ItsGoodButStill/IGBS-Rocket-v2/img/2021/DSC05149.jpg

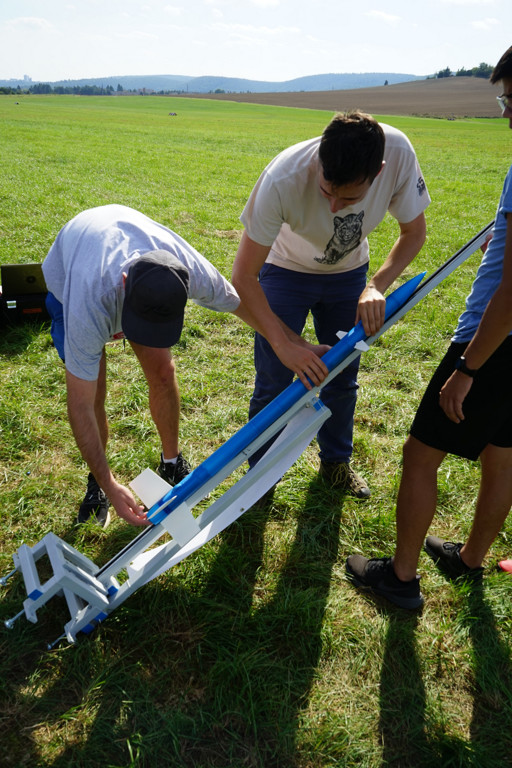
img/2021/DSC05149.jpg
