ItsGoodButStill/IGBS-Rocket-v2/img/team/parezjan.JPEG

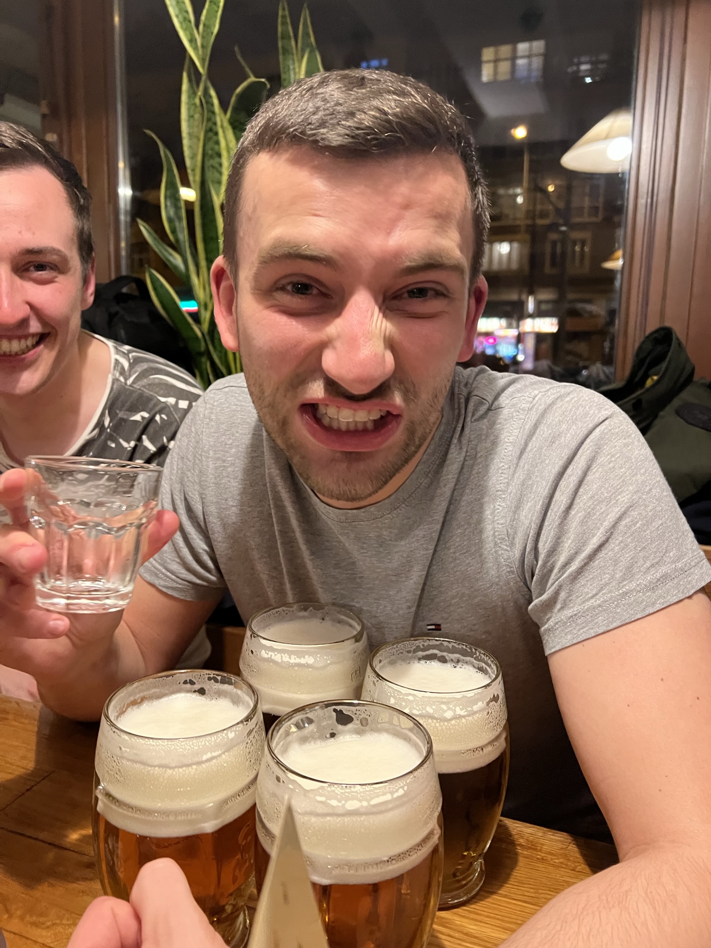
img/team/parezjan.JPEG
