ItsGoodButStill/IGBS-Rocket-v2/README.md

# Its Good But Still V2 (2022)

<p float="left" align="center">
  IGBS 2021
</p>
