ItsGoodButStill/IGBS-Rocket-v2/doc/cubemx.png

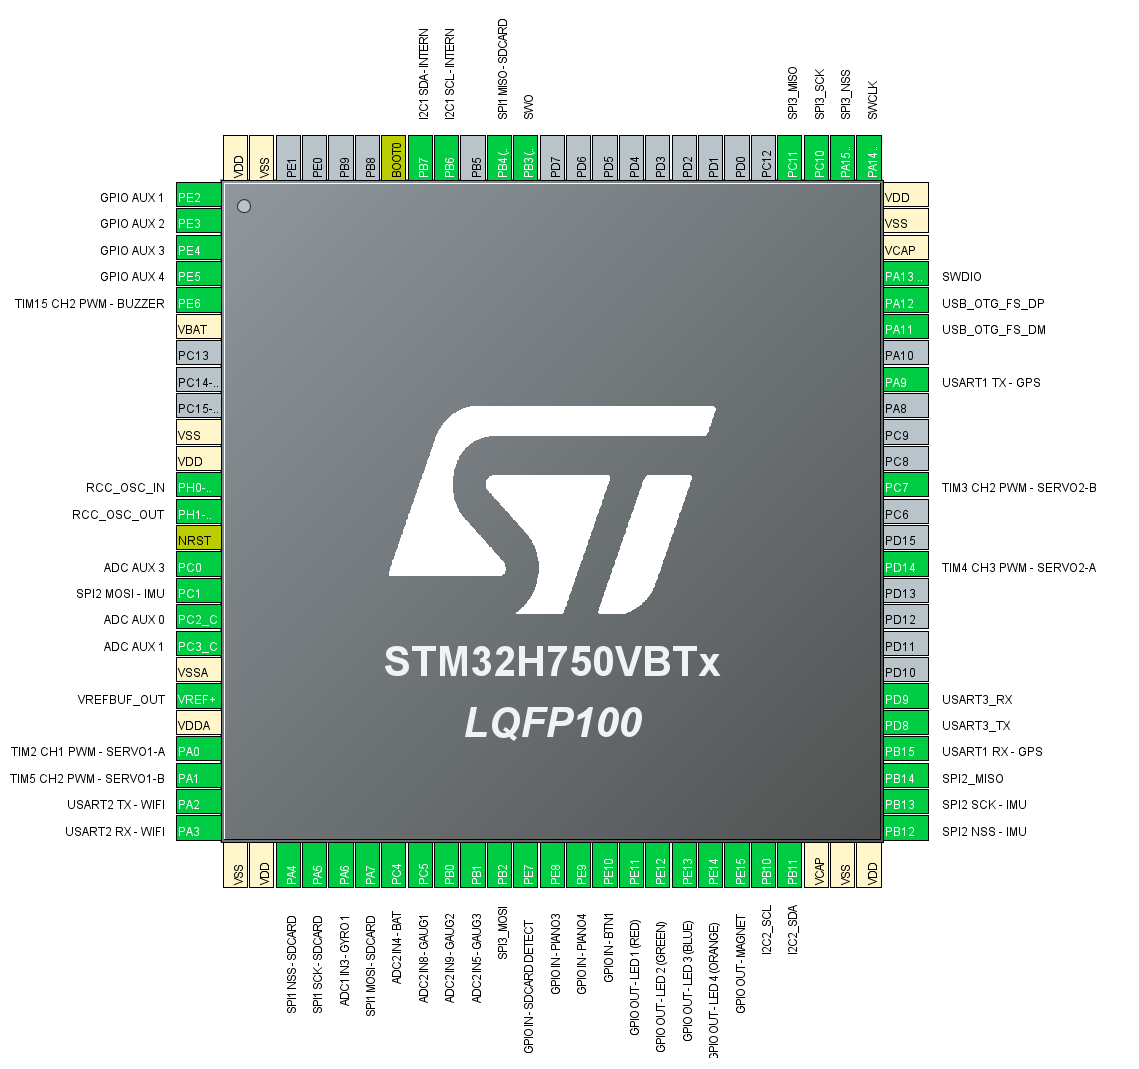
doc/cubemx.png
