ItsGoodButStill/IGBS-Rocket-v2/img/2021/DSC05082.jpg

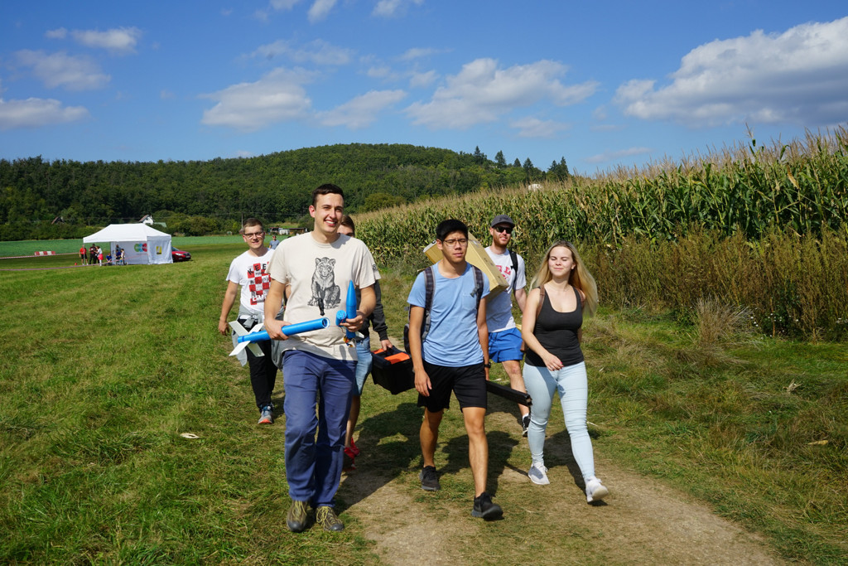
img/2021/DSC05082.jpg
