ItsGoodButStill/IGBS-Rocket-v2/img/2021/DSC05179.jpg

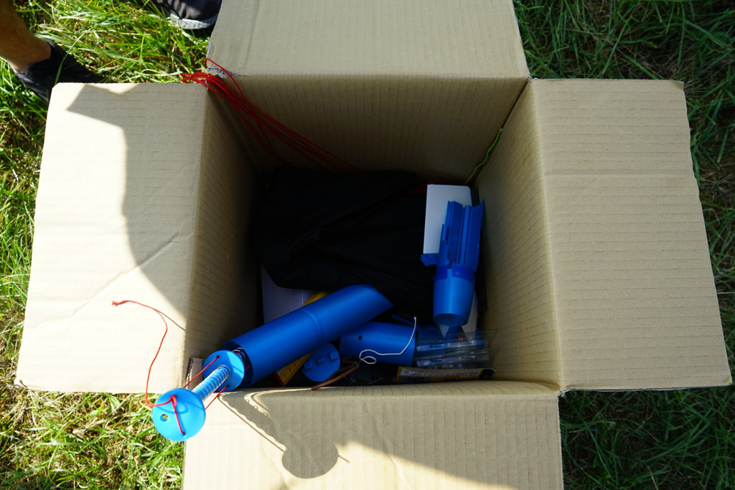
img/2021/DSC05179.jpg
