ItsGoodButStill/IGBS-Rocket-v2/img/IGBS.bmp

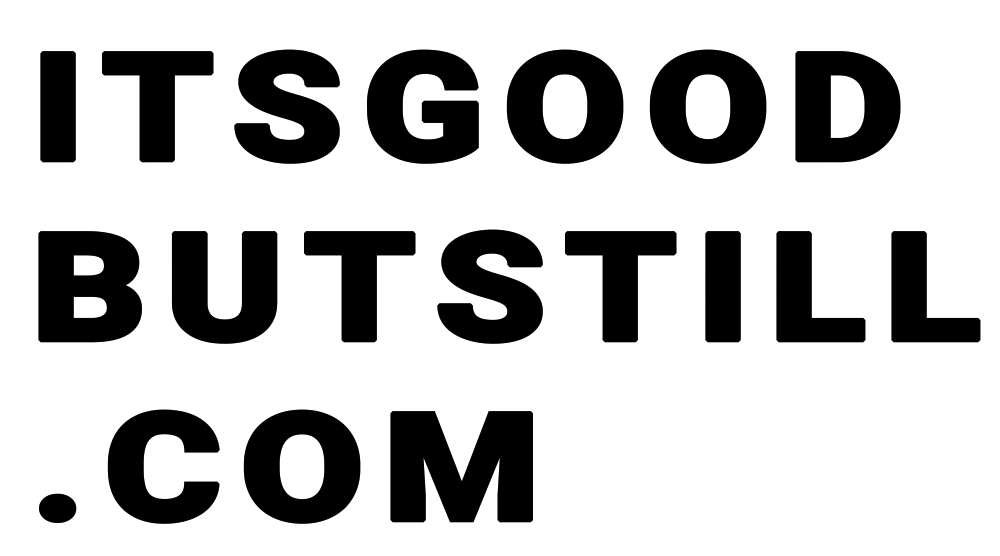
img/IGBS.bmp
