ItsGoodButStill/IGBS-Rocket-v2/img/stumpy.png

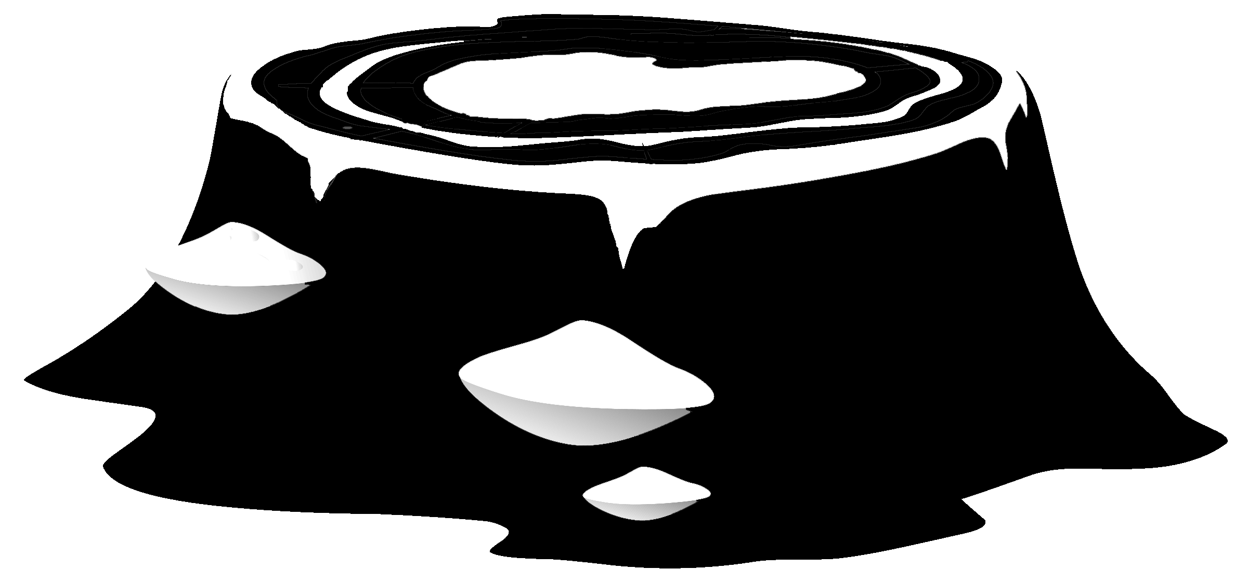
img/stumpy.png
