ItsGoodButStill/IGBS-Rocket-v2/img/symbol_cvut_plna_samostatna_verze_cb.bmp

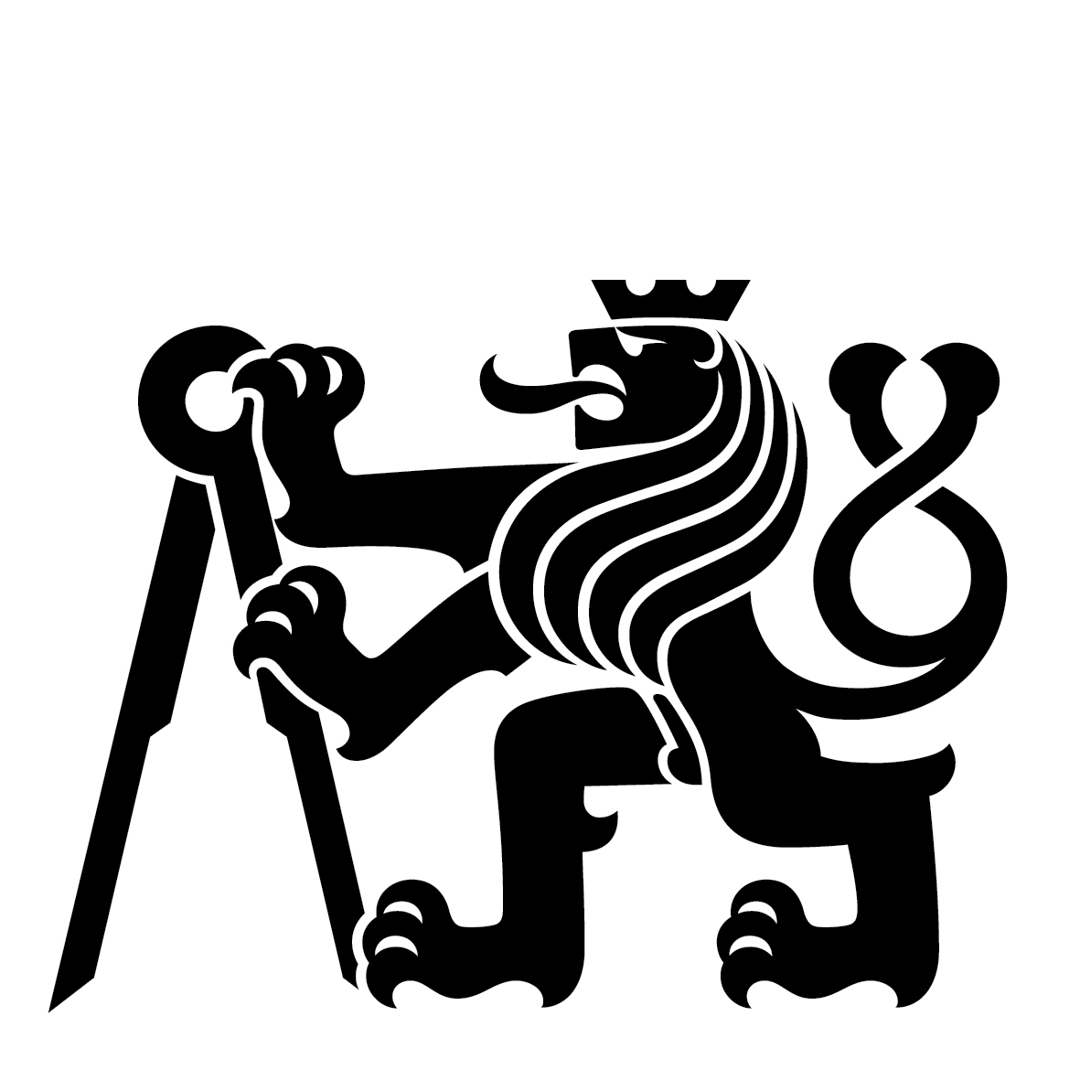
img/symbol_cvut_plna_samostatna_verze_cb.bmp
