ItsGoodButStill/IGBS-Rocket-v2/img/team/IMG_2238.JPEG

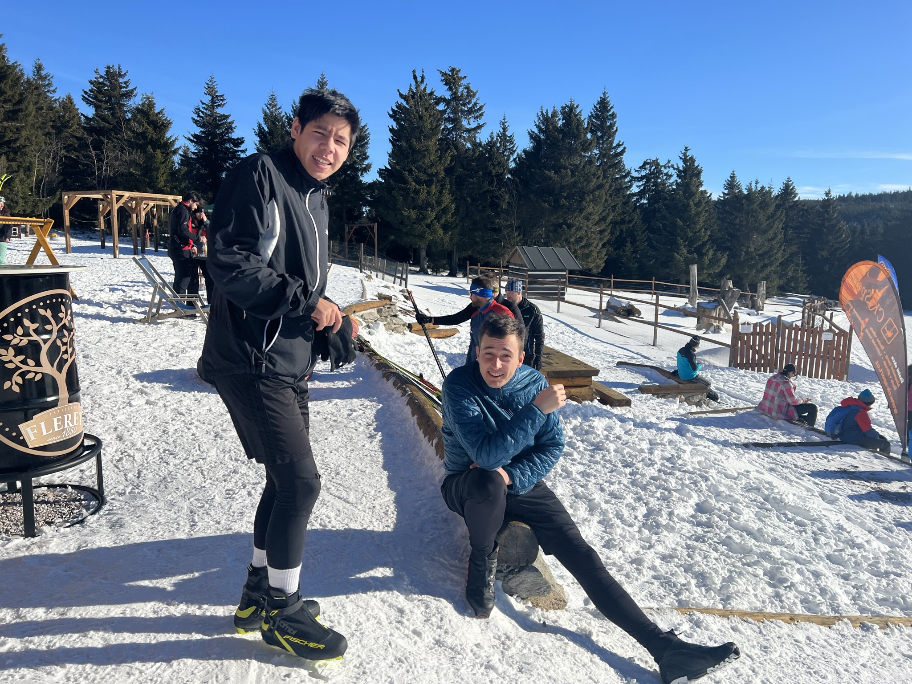
img/team/IMG_2238.JPEG
