ItsGoodButStill/IGBS-Rocket-v2/img/team/IMG_6708.JPEG

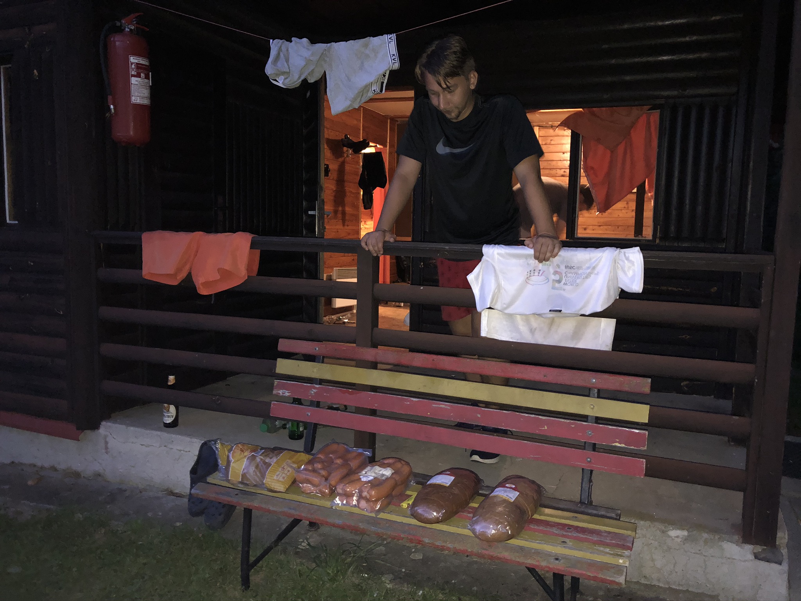
img/team/IMG_6708.JPEG
