ItsGoodButStill/IGBS-Rocket-v2/img/team/kankato2.JPEG

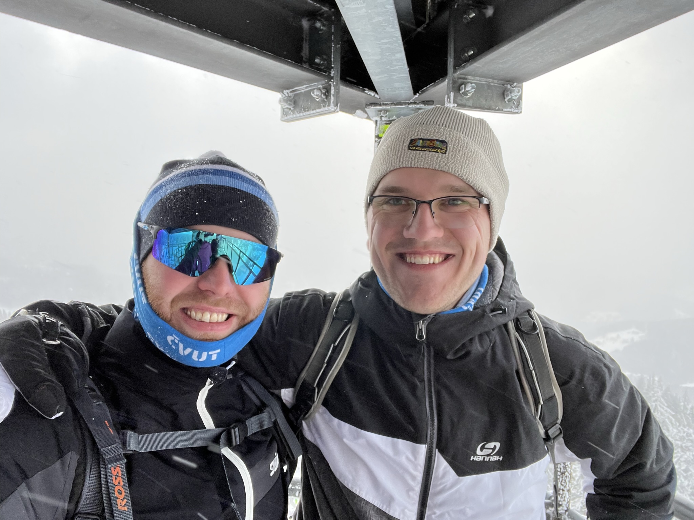
img/team/kankato2.JPEG
