ItsGoodButStill/IGBS-Rocket-v2/img/team/kankato2b.jpg

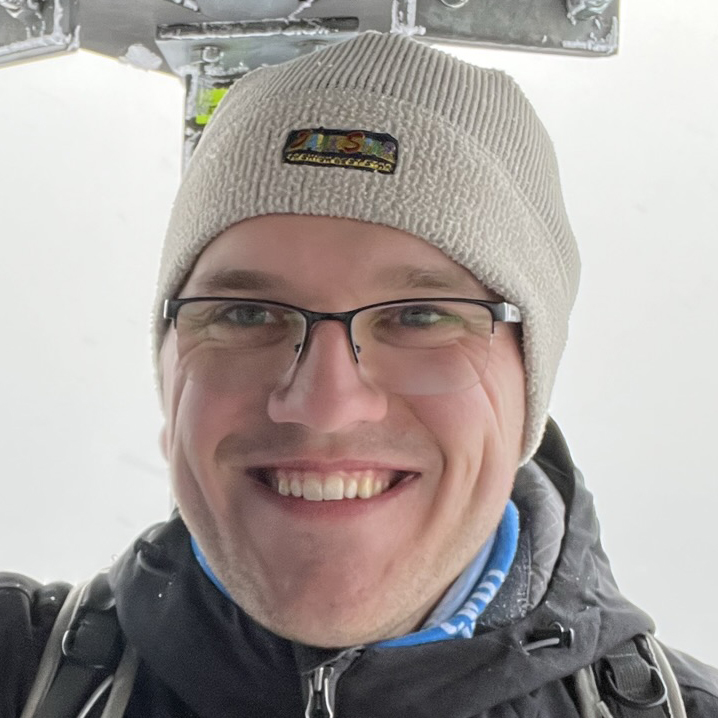
img/team/kankato2b.jpg
