ItsGoodButStill/IGBS-Rocket-v2/img/team/kankato.JPEG

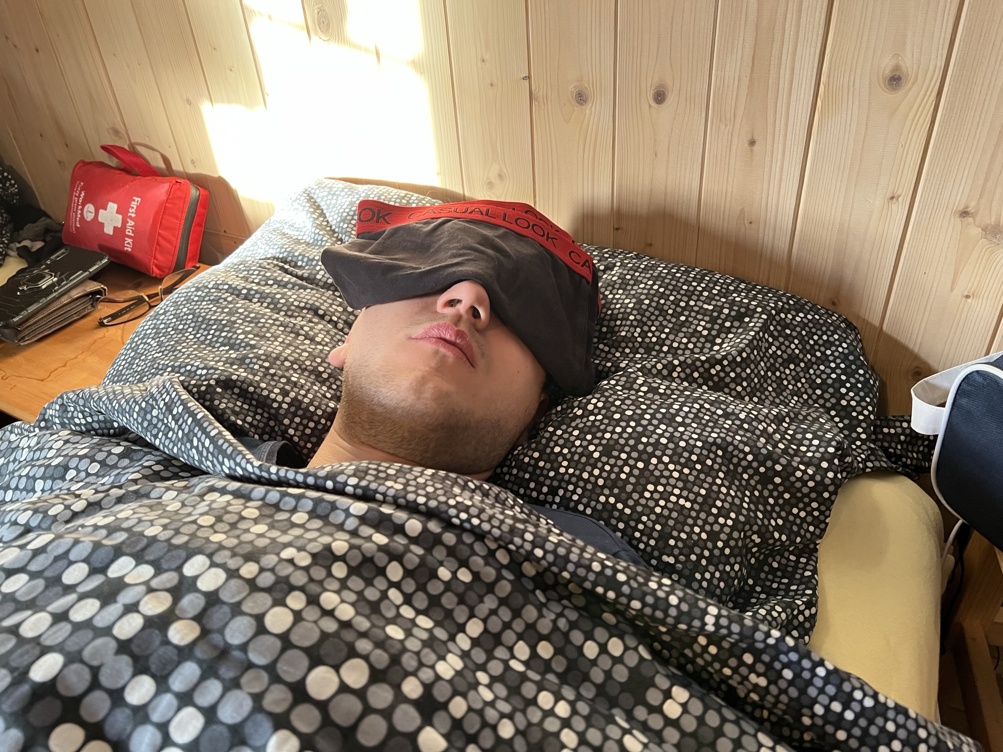
img/team/kankato.JPEG
