ItsGoodButStill/IGBS-Rocket-v2/img/team/kovarpat.jpg

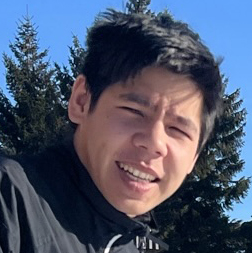
img/team/kovarpat.jpg
