ItsGoodButStill/IGBS-Rocket-v2/img/team/macakpav.jpg

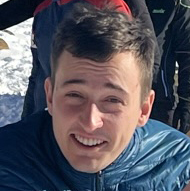
img/team/macakpav.jpg
