ItsGoodButStill/IGBS-Rocket-v2/img/team/parezjan2.JPEG

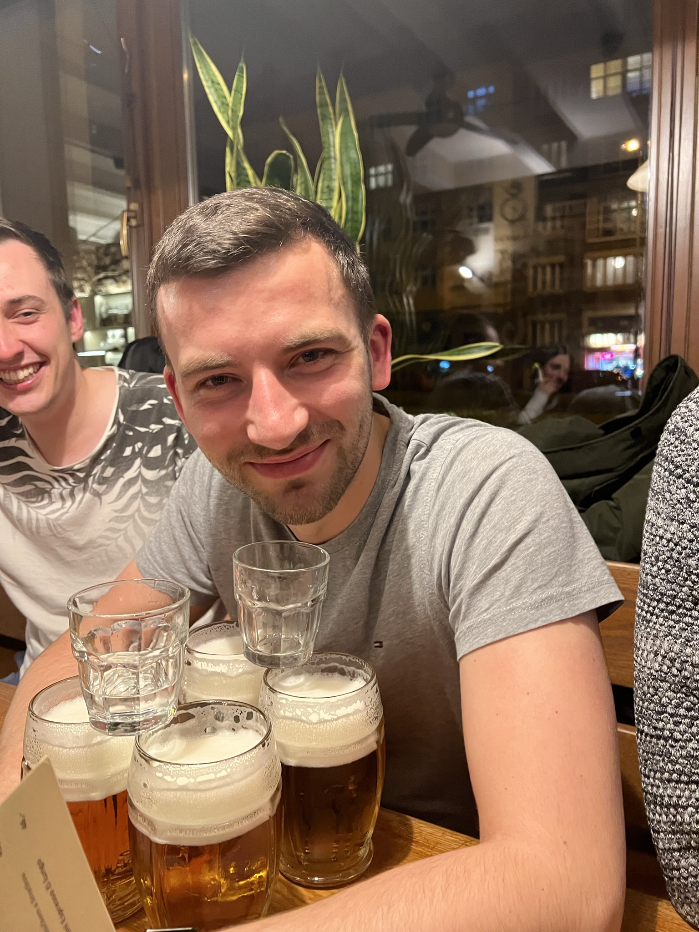
img/team/parezjan2.JPEG
