ItsGoodButStill/IGBS-Rocket-v2/img/team/parezjan2b.jpg

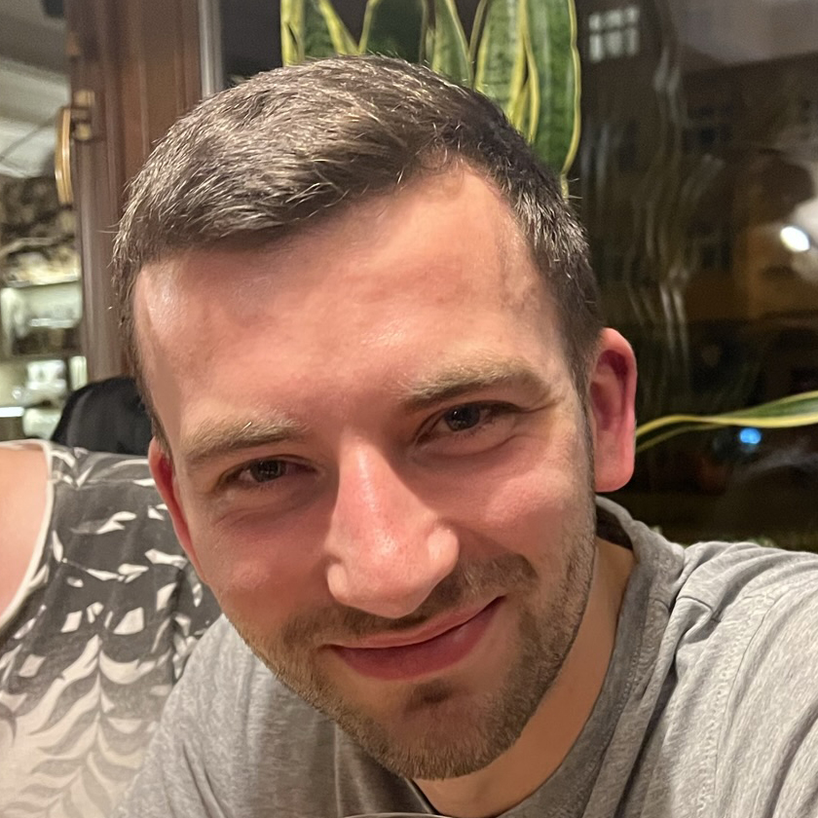
img/team/parezjan2b.jpg
