ItsGoodButStill/IGBS-Rocket-v2/img/team/taterada.jpg

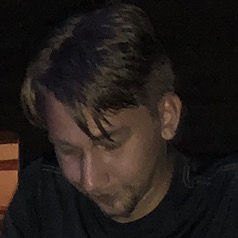
img/team/taterada.jpg
