ItsGoodButStill/IGBS-Rocket-v2/pcb/img/board.PNG

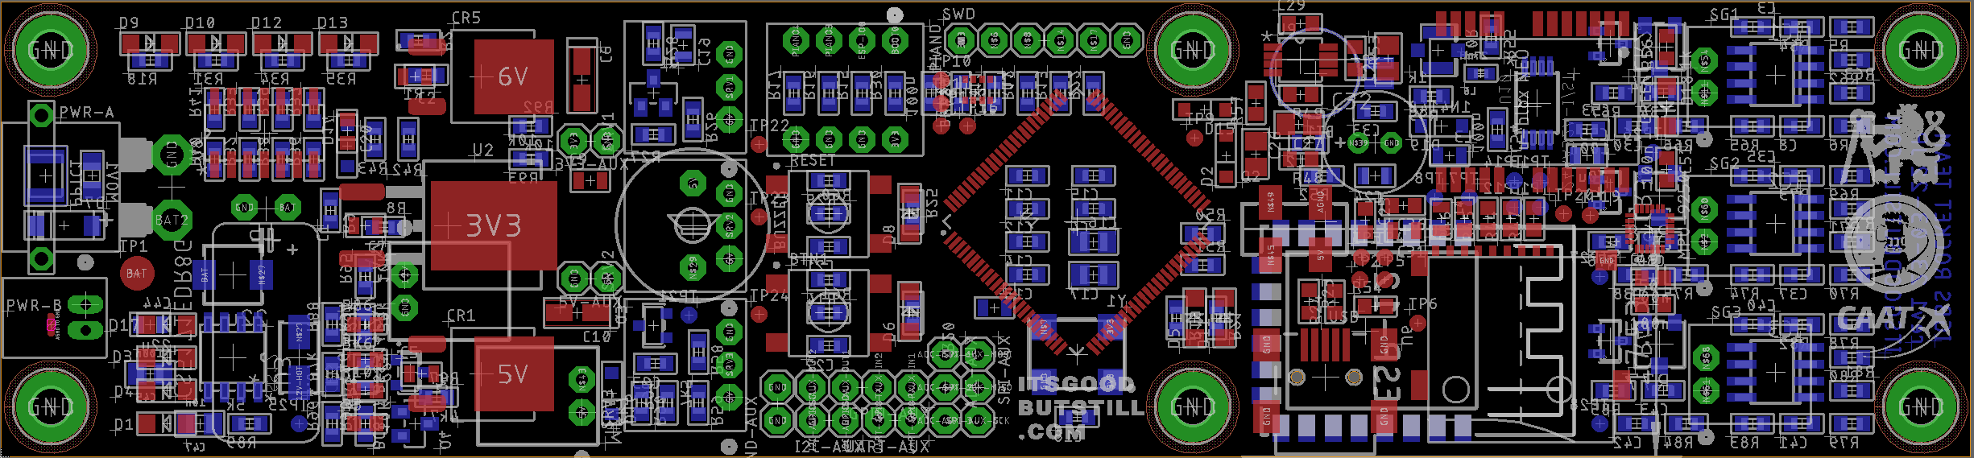
pcb/img/board.PNG
