ItsGoodButStill/IGBS-Rocket-v2/pcb/img/IGBS-Rocket-v2_rev1-3D-bot.png

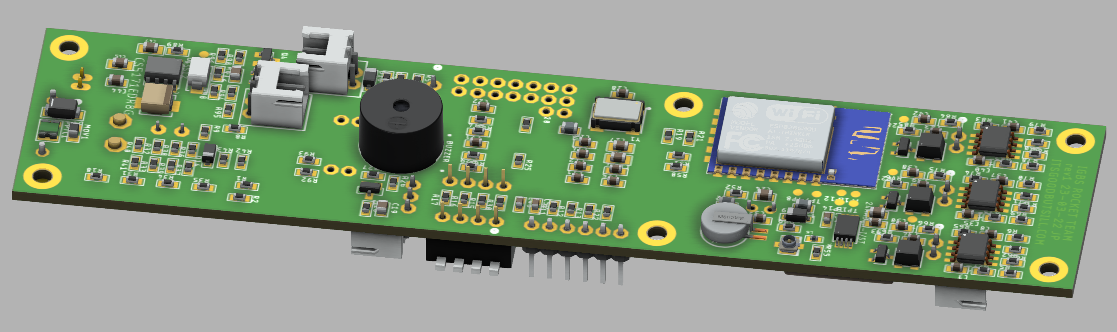
pcb/img/IGBS-Rocket-v2_rev1-3D-bot.png
