ItsGoodButStill/IGBS-Rocket-v2/pcb/img/IGBS-Rocket-v2_rev1-3D-top.png

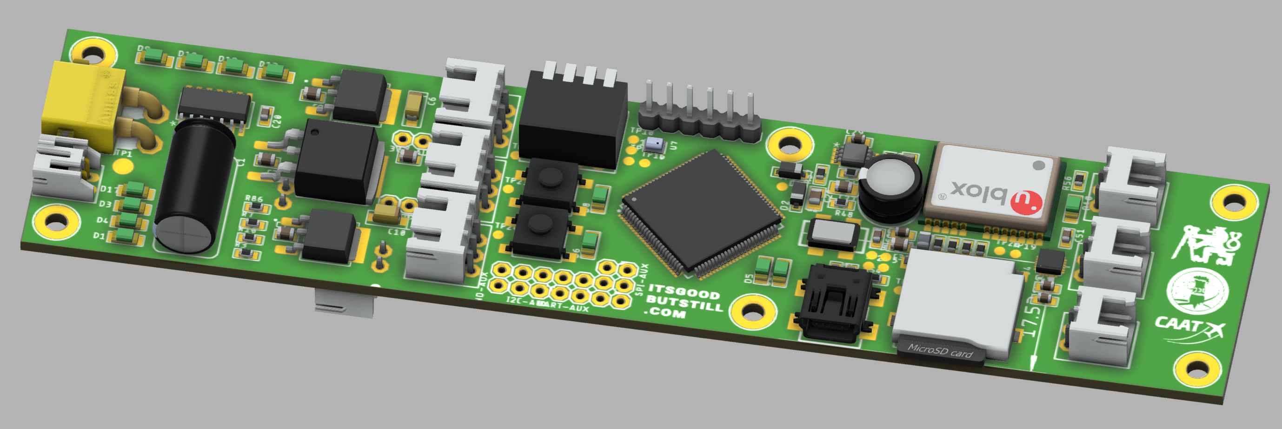
pcb/img/IGBS-Rocket-v2_rev1-3D-top.png
