ItsGoodButStill/IGBS-Rocket-v2/pcb/img/IGBS-Rocket-v2_rev1_bot.png

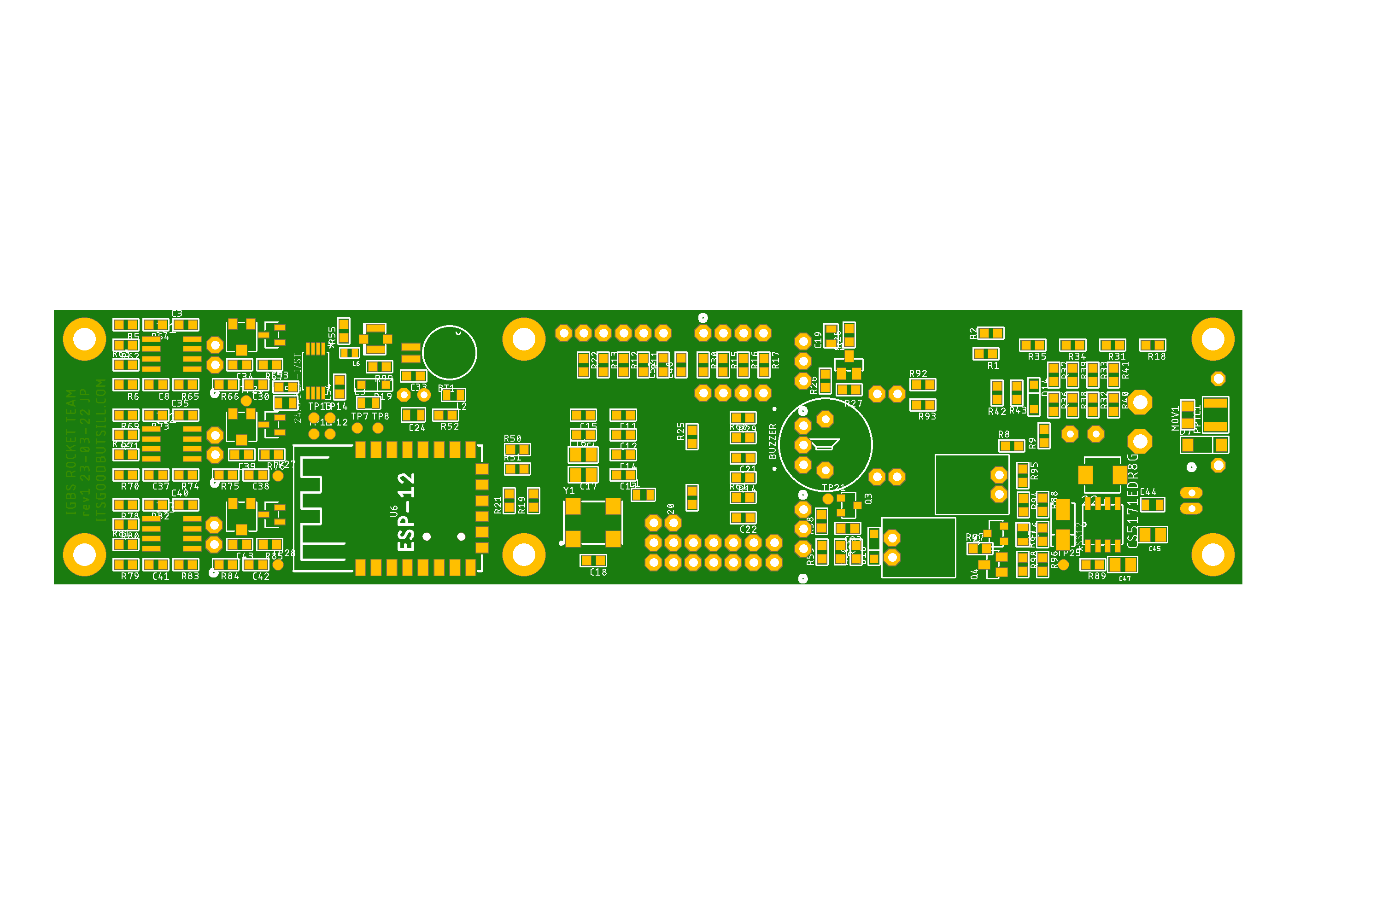
pcb/img/IGBS-Rocket-v2_rev1_bot.png
