ItsGoodButStill/IGBS-Rocket-v2/pcb/bom/Basket_Mar06_0603AM_Mouser.pdf

Sort (https://cz.mouser.com/Cart?grid-column=SortColumn&grid-dir=1) | Product Detail | Description | Quantity | Availability | Unit Price

Ext. Price (CZK)

SHOPPING BASKET | This is not an invoice.
Products (https://cz.mouser.com/electronic-components/) | Manufacturers (https://cz.mouser.com/manufacturer/) | Services & Tools (https://cz.mouser.com/servicesandtools/) | Technical Resources (https://cz.mouser.com/technical-resources/) | Help (https://cz.mouser.com/help/) | Account & Orders
Contact Mouser (Brno) +420 517070880 (https://cz.mouser.com/contact/) | Feedback (https://cz.mouser.com/feedback/?source=actionbarnew) | Change Location (https://cz.mouser.com/cs/localsites) | English | Kč CZK

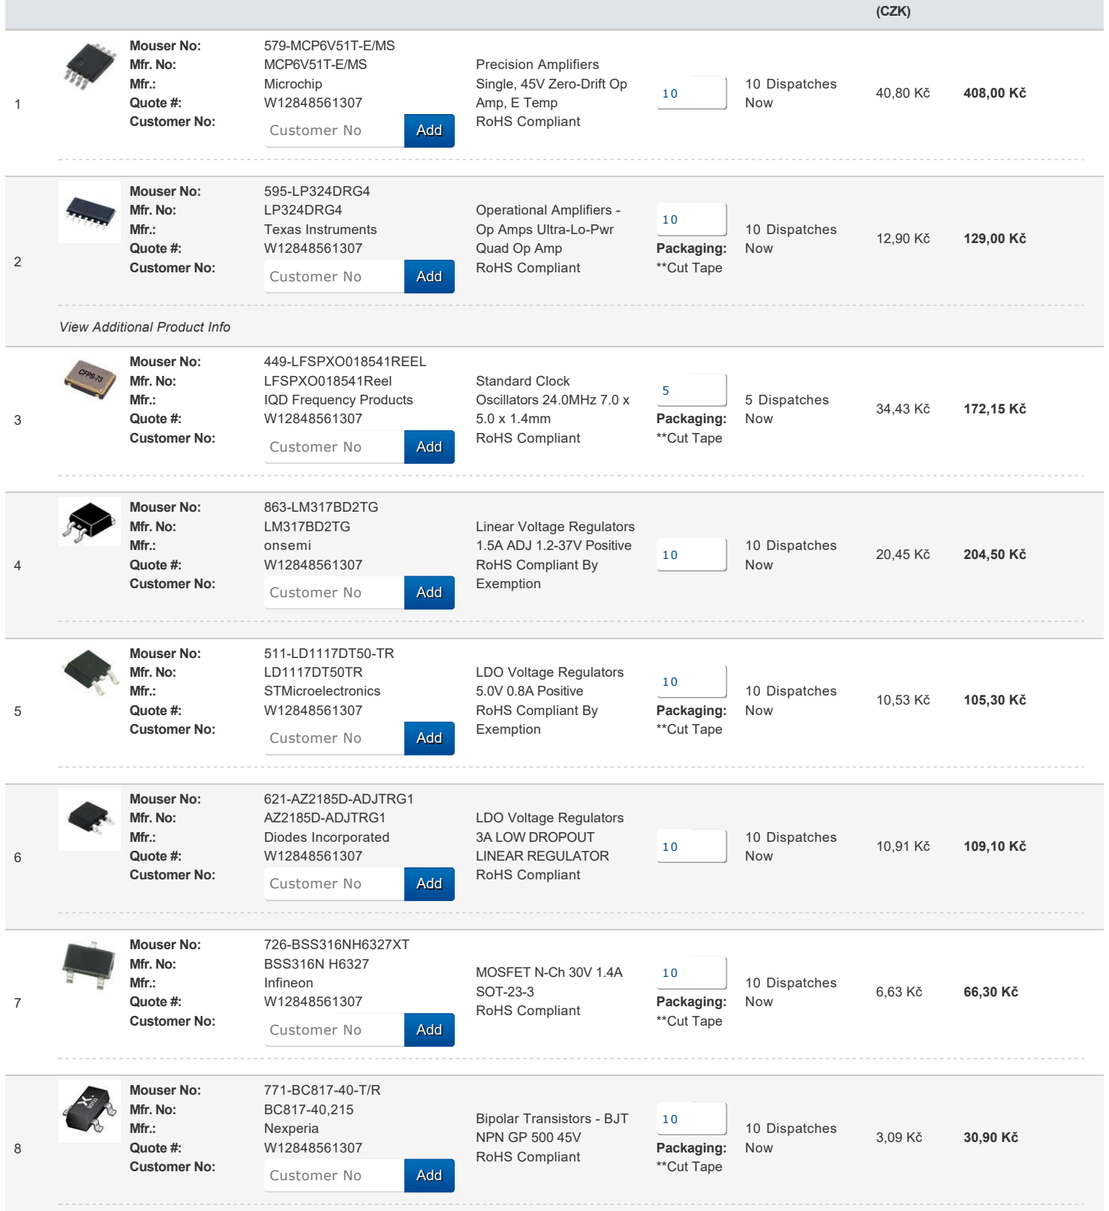
[picture p31: figure]
Mouser No:; 579-MCP6V51T-E/MS; Mfr. No:; MCP6V51T-E/MS; Mfr.:; Microchip; Quote #:; Customer No:; 595-LP324DRG4; LP324DRG4; Texas Instruments; 449-LFSPXO018541REEL; LFSPXO018541Reel; IQD Frequency Products; onsemi; STMicroelectronics; 621-AZ2185D-ADJTRG1; AZ2185D-ADJTRG1; Diodes Incorporated; 726-BSS316NH6327XT; BSS316N H6327; Infineon; Nexperia; (CZK); View Additional Product Info; Precision Amplifiers; Single, 45V Zero-Drift Op; Amp, E Temp; RoHS Compliant; 10 Dispatches; Now; Operational Amplifiers; Op Amps Ultra-Lo-Pwr; Quad Op Amp; Packaging:; **Cut Tape; Standard Clock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

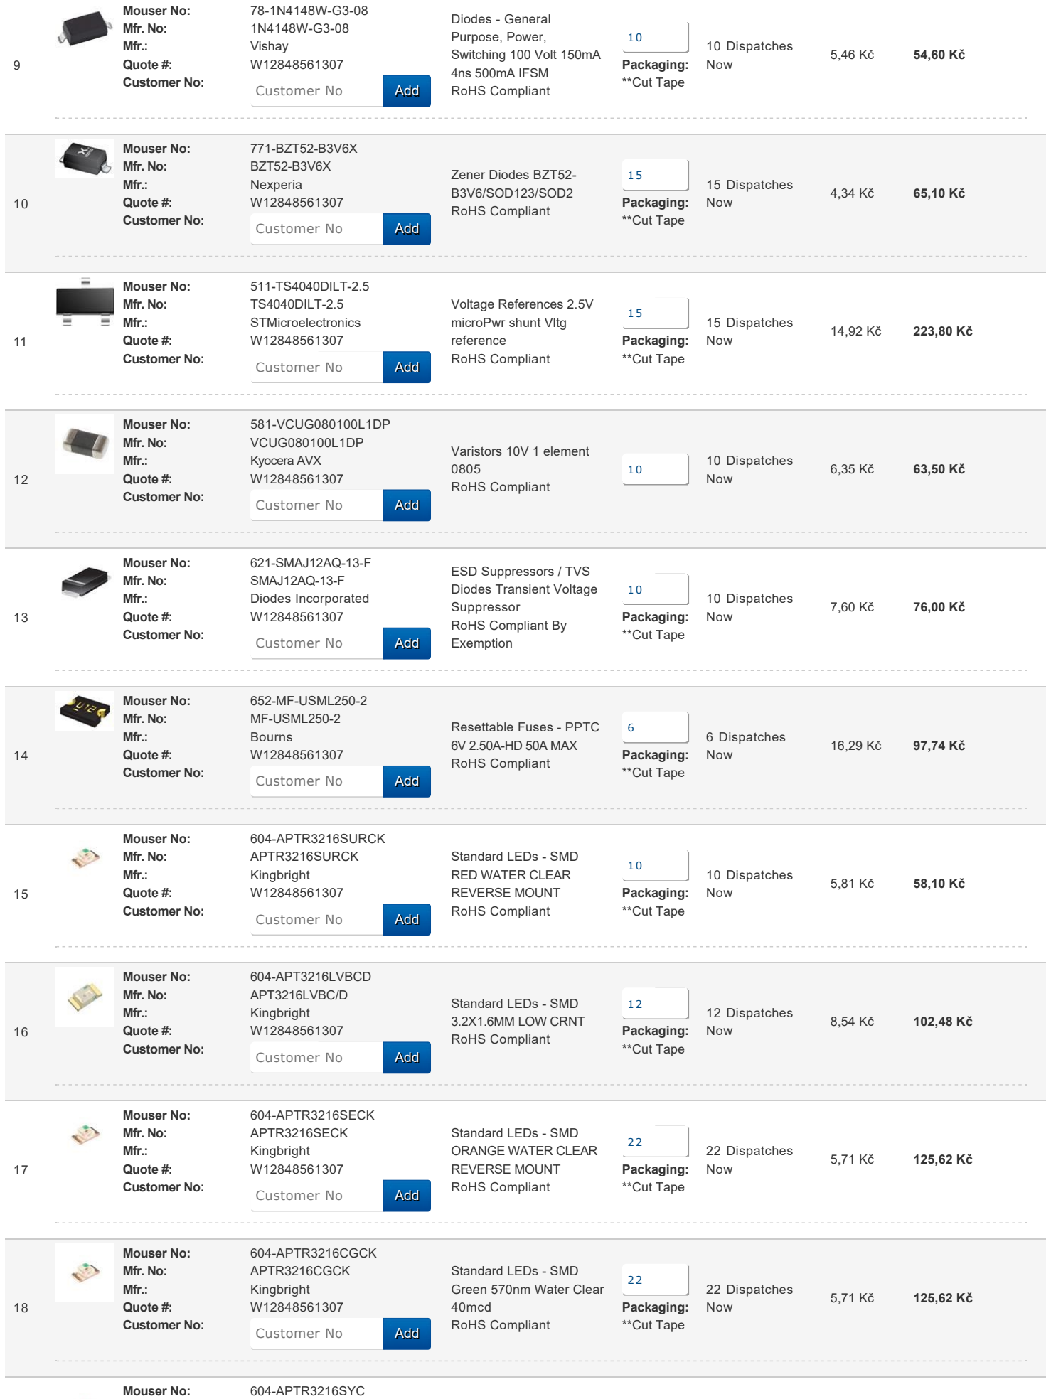
[picture p32: figure]
Mouser No:; Mfr. No:; Mfr.:; Vishay; 771-BZT52-B3V6X; BZT52-B3V6X; Nexperia; Quote #:; Customer No:; 511-TS4040DILT-2.5; TS4040DILT-2.5; STMicroelectronics; 581-VCUG080100L1DP; VCUG080100L1DP; Kyocera AVX; 621-SMAJ12AQ-13-F; SMAJ12AQ-13-F; Diodes Incorporated; 652-MF-USML250-2; MF-USML250-2; Bourns; 604-APTR3216SURCK; APTR3216SURCK; Kingbright; 604-APT3216LVBCD; APT3216LVBC/D; 604-APTR3216SECK; APTR3216SECK; 604-APTR3216CGCK; APTR3216CGCK; 604-APTR3216SYC; Diodes General; Purpose, Power,; Switching 100 Volt 150mA; 4ns 500mA IFSM; Zener Diodes BZT52-; B3V6/SOD123/SOD2; RoHS Compliant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

Mfr. No: | APTR3216SYC
Mfr.: | Kingbright
Mouser No: | 81-PVG3A504C01R00 (https://cz.mouser.com/ProductDetail/81-PVG3A504C01R00)
Mfr. No: | PVG3A504C01R00
Mfr.: | Bourns
Quote #: | W12848561307
Customer No:
Mouser No: | 652-CR0603-FX-103ELF (https://cz.mouser.com/ProductDetail/652-CR0603-FX-103ELF)
Mfr. No: | CR0603-FX-1003ELF
Mfr.: | Bourns
Quote #: | W12848561307
Customer No:

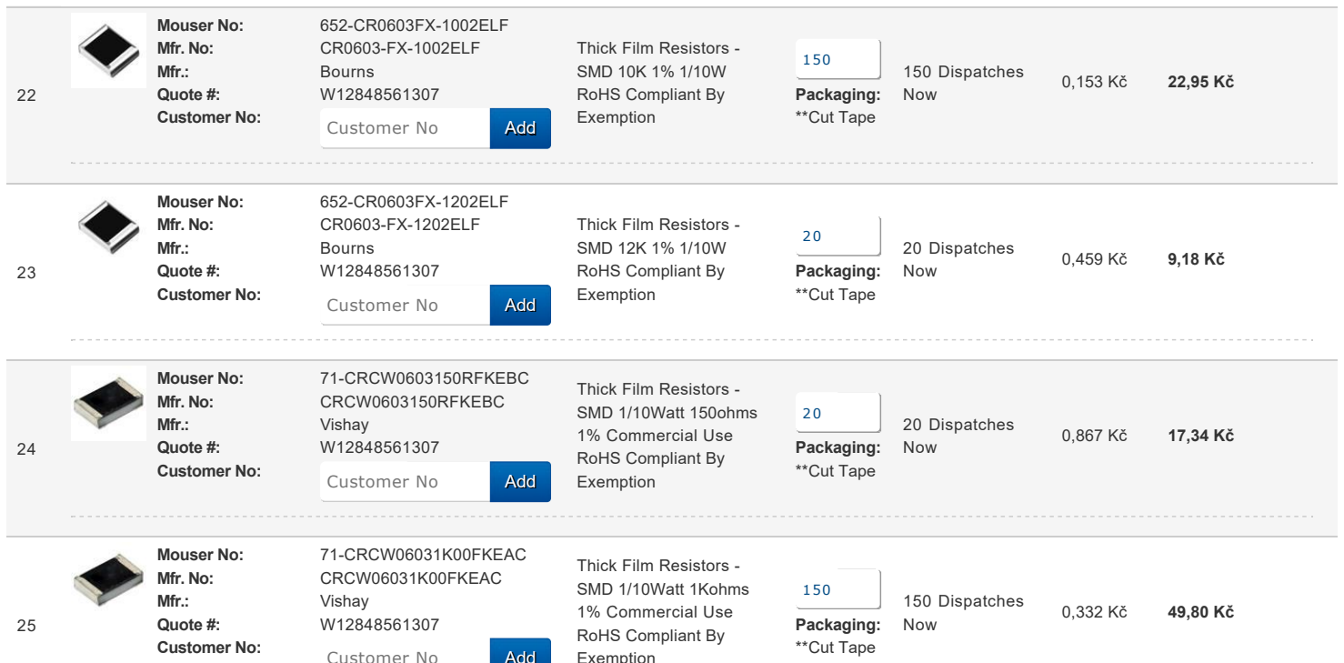
[picture p33: figure]
Mouser No:; 652-CR0603FX-1002ELF; Mfr. No:; CR0603-FX-1002ELF; Mfr.:; Bourns; Quote #:; Customer No:; 652-CR0603FX-1202ELF; CR0603-FX-1202ELF; 71-CRCW0603150RFKEBC; CRCW0603150RFKEBC; Vishay; 71-CRCW06031K00FKEAC; CRCW06031K00FKEAC; Thick Film Resistors; SMD 10K 1% 1/10W; RoHS Compliant By; Exemption; Packaging:; **Cut Tape; 150 Dispatches; Now; SMD 12K 1% 1/10W; 20 Dispatches; SMD 1/10Watt 150ohms; 1% Commercial Use; SMD 1/10Watt 1Kohms; Customer No; Add

Mouser No: | 652-CR0603FX-1501ELF (https://cz.mouser.com/ProductDetail/652-CR0603FX-1501ELF)
Mfr. No: | CR0603-FX-1501ELF
Mfr.: | Bourns
Quote #: | W12848561307
Customer No:

20

21

26

Standard LEDs SMD
YELLOW WATER CLEAR
REVERSE MOUNT
7,42 Kč | 74,20 Kč

Trimmer Resistors SMD
500K Ohm 20% 1/4W
RoHS Compliant By
Exemption

15

Packaging:
**Cut Tape (https://cz.mouser.com/Cart/MiniReelWithNoJavaScript.aspx)

15 Dispatches
Now

24,33 Kč 364,95 Kč

Thick Film Resistors
SMD 100K 1% 1/10 WATT
RoHS Compliant By
Exemption

50

Packaging:
**Cut Tape (https://cz.mouser.com/Cart/MiniReelWithNoJavaScript.aspx)

50 Dispatches
Now

0,383 Kč 19,15 Kč

Exemption

Thick Film Resistors
SMD 1.5K 1% 1/10W
RoHS Compliant By
Exemption

40

Packaging:
**Cut Tape (https://cz.mouser.com/Cart/MiniReelWithNoJavaScript.aspx)

40 Dispatches
Now
0,332 Kč | 13,28 Kč
Customer No | Add
Customer No | Add
Customer No | Add
Customer No | Add

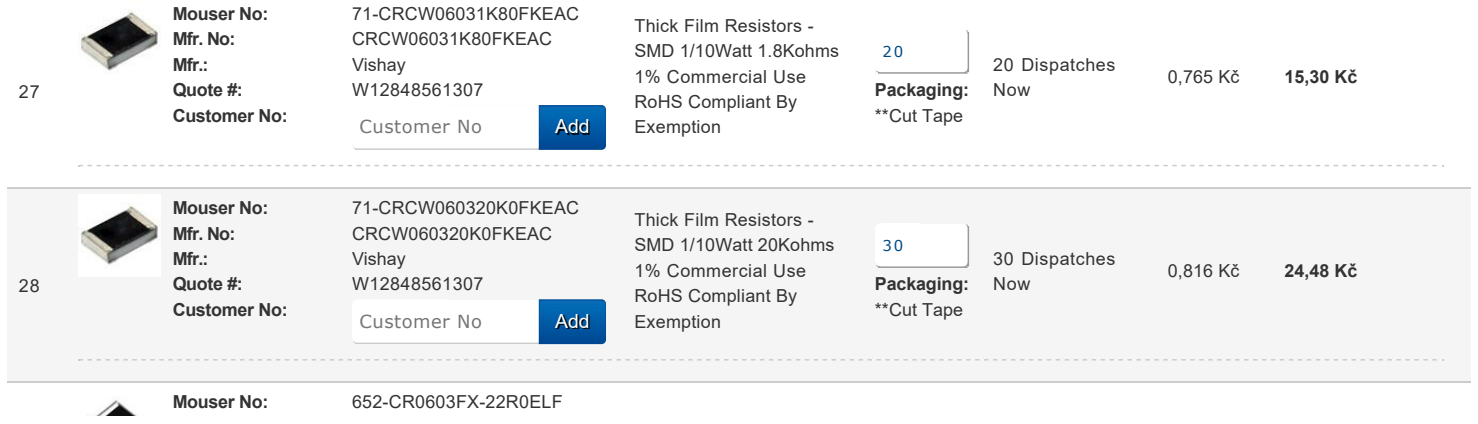
[picture p34: figure]
Mouser No:; 71-CRCW06031K80FKEAC; Mfr. No:; CRCW06031K80FKEAC; Mfr.:; Vishay; Quote #:; Customer No:; 71-CRCW060320K0FKEAC; CRCW060320K0FKEAC; 652-CR0603FX-22R0ELF; CR0603-FX-22R0ELF; Bourns; Thick Film Resistors; SMD 1/10Watt 1.8Kohms; 1% Commercial Use; RoHS Compliant By; Exemption; Packaging:; **Cut Tape; 20 Dispatches; Now; SMD 1/10Watt 20Kohms; 30 Dispatches; SMD 22 ohm 1%; Customer No; Add

Mfr. No: | CR0603-FX-22R0ELF
Mouser No: | 603-RC0603FR-13240RL (https://cz.mouser.com/ProductDetail/603-RC0603FR-13240RL)
Mfr. No: | RC0603FR-13240RL
Mfr.: | YAGEO
Quote #: | W12848561307
Customer No:
Mouser No: | 652-CR0603FX-3300ELF (https://cz.mouser.com/ProductDetail/652-CR0603FX-3300ELF)
Mfr. No: | CR0603-FX-3300ELF
Mfr.: | Bourns
Quote #: | W12848561307
Customer No:

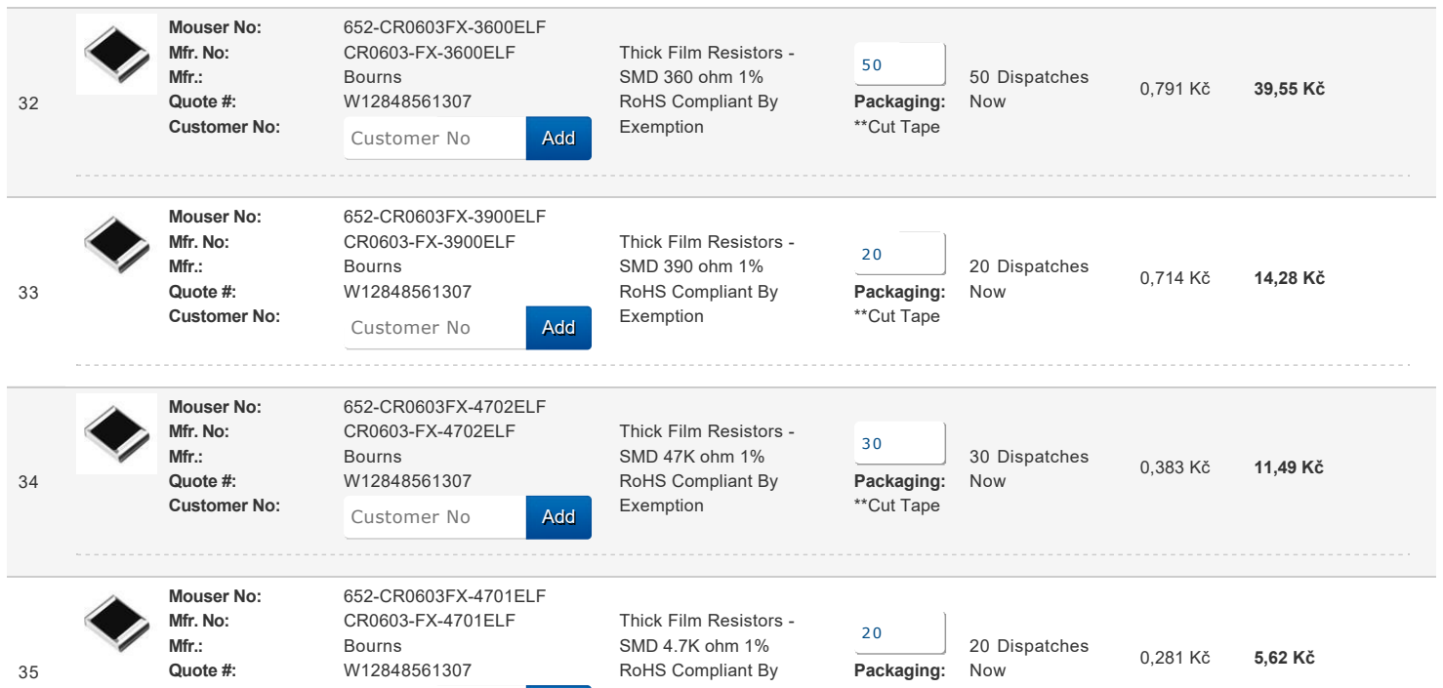
[picture p35: figure]
Mouser No:; 652-CR0603FX-3600ELF; Mfr. No:; CR0603-FX-3600ELF; Mfr.:; Bourns; Quote #:; Customer No:; 652-CR0603FX-3900ELF; CR0603-FX-3900ELF; 652-CR0603FX-4702ELF; CR0603-FX-4702ELF; 652-CR0603FX-4701ELF; CR0603-FX-4701ELF; Thick Film Resistors; SMD 360 ohm 1%; RoHS Compliant By; Exemption; Packaging:; **Cut Tape; 50 Dispatches; Now; SMD 390 ohm 1%; 20 Dispatches; SMD 47K ohm 1%; 30 Dispatches; SMD 4.7K ohm 1%; Customer No; Add

Customer No:

Mouser No: | 652-CR0603FX-4703ELF (https://cz.mouser.com/ProductDetail/652-CR0603FX-4703ELF)
Mfr. No: | CR0603-FX-4703ELF
Mfr.: | Bourns
Quote #: | W12848561307
Customer No:

30

31

36

SMD 22 ohm 1%
0,383 Kč 19,15 Kč

Thick Film Resistors
SMD 240 Ohms 100-
200mW 0603 1%
RoHS Compliant By
Exemption

20

Packaging:
**Cut Tape (https://cz.mouser.com/Cart/MiniReelWithNoJavaScript.aspx)

20 Dispatches
Now

0,561 Kč 11,22 Kč

Thick Film Resistors
SMD 330 ohm 1%
RoHS Compliant By
Exemption

20

Packaging:
**Cut Tape (https://cz.mouser.com/Cart/MiniReelWithNoJavaScript.aspx)

20 Dispatches
Now
1,25 Kč | 25,00 Kč

Exemption

**Cut Tape (https://cz.mouser.com/Cart/MiniReelWithNoJavaScript.aspx)

Thick Film Resistors
SMD 470K ohm 1%
RoHS Compliant By
Exemption

25

Packaging:
**Cut Tape (https://cz.mouser.com/Cart/MiniReelWithNoJavaScript.aspx)

25 Dispatches
Now
0,383 Kč | 9,58 Kč
Customer No | Add
Customer No | Add
Customer No | Add
Customer No | Add

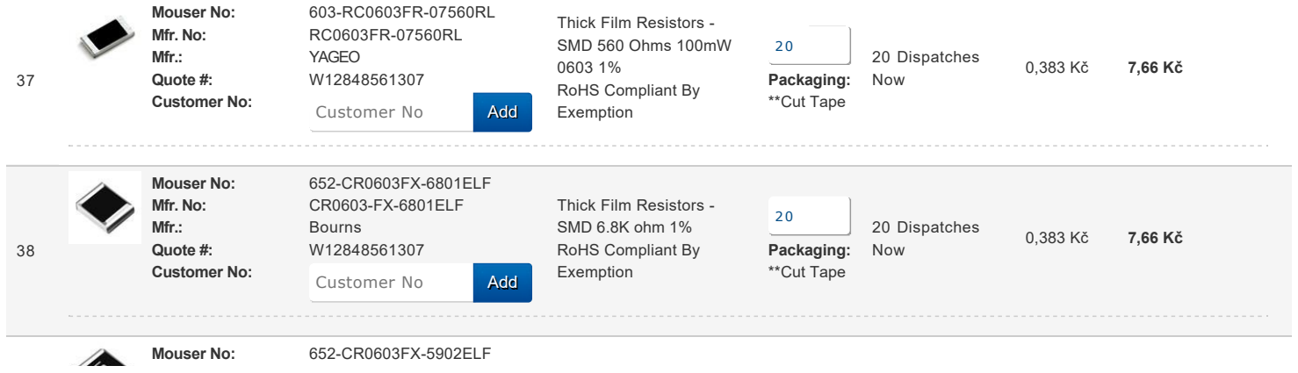
[picture p36: figure]
Mouser No:; Mfr. No:; Mfr.:; YAGEO; Quote #:; Customer No:; 652-CR0603FX-6801ELF; CR0603-FX-6801ELF; Bourns; 652-CR0603FX-5902ELF; CR0603-FX-5902ELF; Thick Film Resistors; SMD 560 Ohms 100mW; RoHS Compliant By; Exemption; Packaging:; **Cut Tape; 20 Dispatches; Now; SMD 6.8K ohm 1%; SMD 59K ohm 1%; Customer No; Add

Mfr. No: | CR0603-FX-5902ELF
Mouser No: | 652-CR0603FX-7501ELF (https://cz.mouser.com/ProductDetail/652-CR0603FX-7501ELF)
Mfr. No: | CR0603-FX-7501ELF
Mfr.: | Bourns
Quote #: | W12848561307
Customer No:
Mouser No: | 652-CR0603FX-9101ELF (https://cz.mouser.com/ProductDetail/652-CR0603FX-9101ELF)
Mfr. No: | CR0603-FX-9101ELF
Mfr.: | Bourns
Quote #: | W12848561307
Customer No:

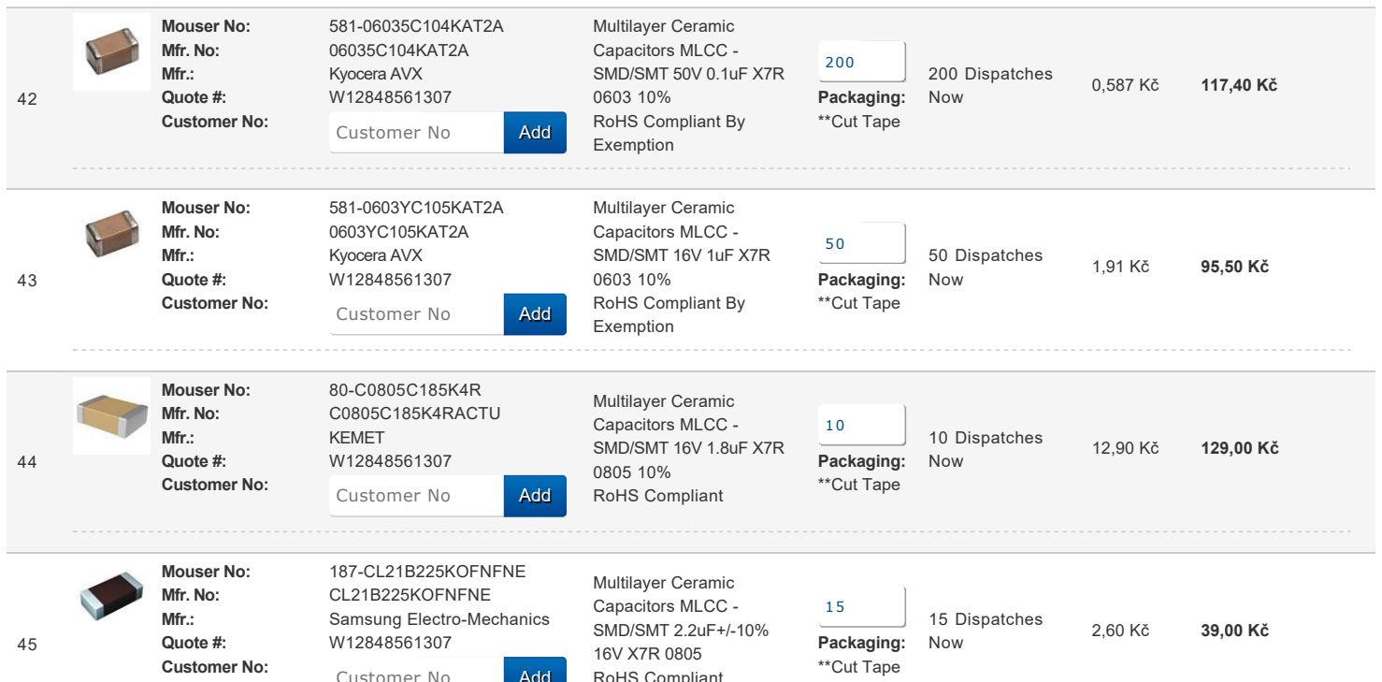
[picture p37: figure]
Mouser No:; 581-06035C104KAT2A; Mfr. No:; 06035C104KAT2A; Mfr.:; Kyocera AVX; Quote #:; Customer No:; 581-0603YC105KAT2A; 0603YC105KAT2A; C0805C185K4RACTU; KEMET; 187-CL21B225KOFNFNE; CL21B225KOFNFNE; Samsung Electro-Mechanics; Multilayer Ceramic; Capacitors MLCC; SMD/SMT 50V 0.1uF X7R; RoHS Compliant By; Exemption; Packaging:; **Cut Tape; 200 Dispatches; Now; SMD/SMT 16V 1uF X7R; 50 Dispatches; SMD/SMT 16V 1.8uF X7R; RoHS Compliant; 10 Dispatches; SMD/SMT 2.2uF+/-10%; 15 Dispatches; Customer No; Add

Mouser No: | 81-GRM21BR71C475KE1L (https://cz.mouser.com/ProductDetail/81-GRM21BR71C475KE1L)
Mfr. No: | GRM21BR71C475KE51L
Mfr.: | Murata
Quote #: | W12848561307
Customer No:

40

41

46

SMD 59K ohm 1%
0,893 Kč 17,86 Kč

Thick Film Resistors
SMD 7.50K ohm 1%
RoHS Compliant By
Exemption

20

Packaging:
**Cut Tape (https://cz.mouser.com/Cart/MiniReelWithNoJavaScript.aspx)

20 Dispatches
Now

0,383 Kč 7,66 Kč

Thick Film Resistors
SMD 9.1K ohm 1%
RoHS Compliant By
Exemption

20

Packaging:
**Cut Tape (https://cz.mouser.com/Cart/MiniReelWithNoJavaScript.aspx)

20 Dispatches
Now
1,15 Kč | 23,00 Kč

RoHS Compliant

Multilayer Ceramic
Capacitors MLCC
SMD/SMT 4.7UF 16V 10%
0805
RoHS Compliant

15

Packaging:
**Cut Tape (https://cz.mouser.com/Cart/MiniReelWithNoJavaScript.aspx)

15 Dispatches
Now
2,98 Kč | 44,70 Kč
Customer No | Add
Customer No | Add
Customer No | Add
Customer No | Add

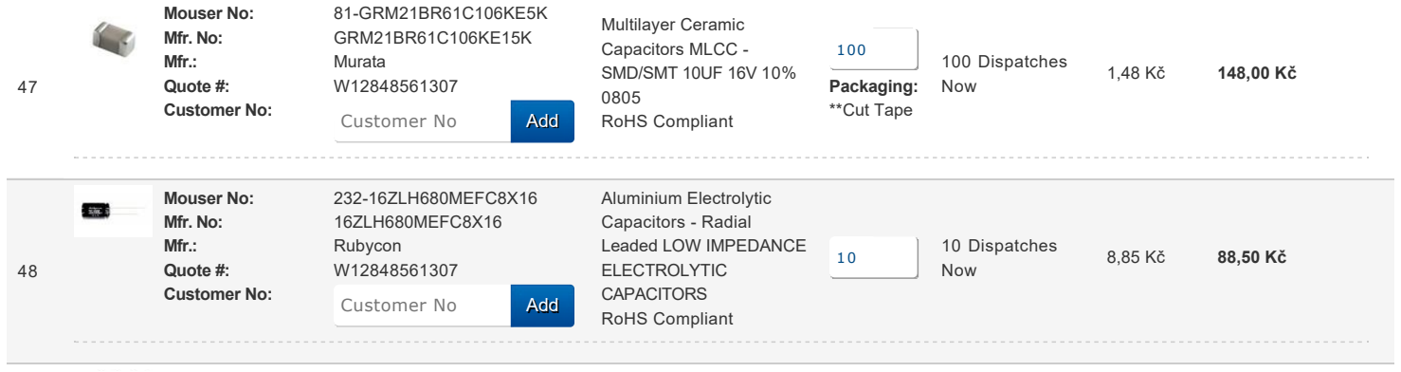
[picture p38: figure]
Mouser No:; 81-GRM21BR61C106KE5K; Mfr. No:; GRM21BR61C106KE15K; Mfr.:; Murata; Quote #:; Customer No:; 232-16ZLH680MEFC8X16; 16ZLH680MEFC8X16; Rubycon; 667-ECE-A0JKS331; ECE-A0JKS331; Panasonic; Multilayer Ceramic; Capacitors MLCC; SMD/SMT 10UF 16V 10%; RoHS Compliant; Packaging:; **Cut Tape; 100 Dispatches; Now; Aluminium Electrolytic; Capacitors Radial; Leaded LOW IMPEDANCE; ELECTROLYTIC; CAPACITORS; 10 Dispatches; Customer No; Add

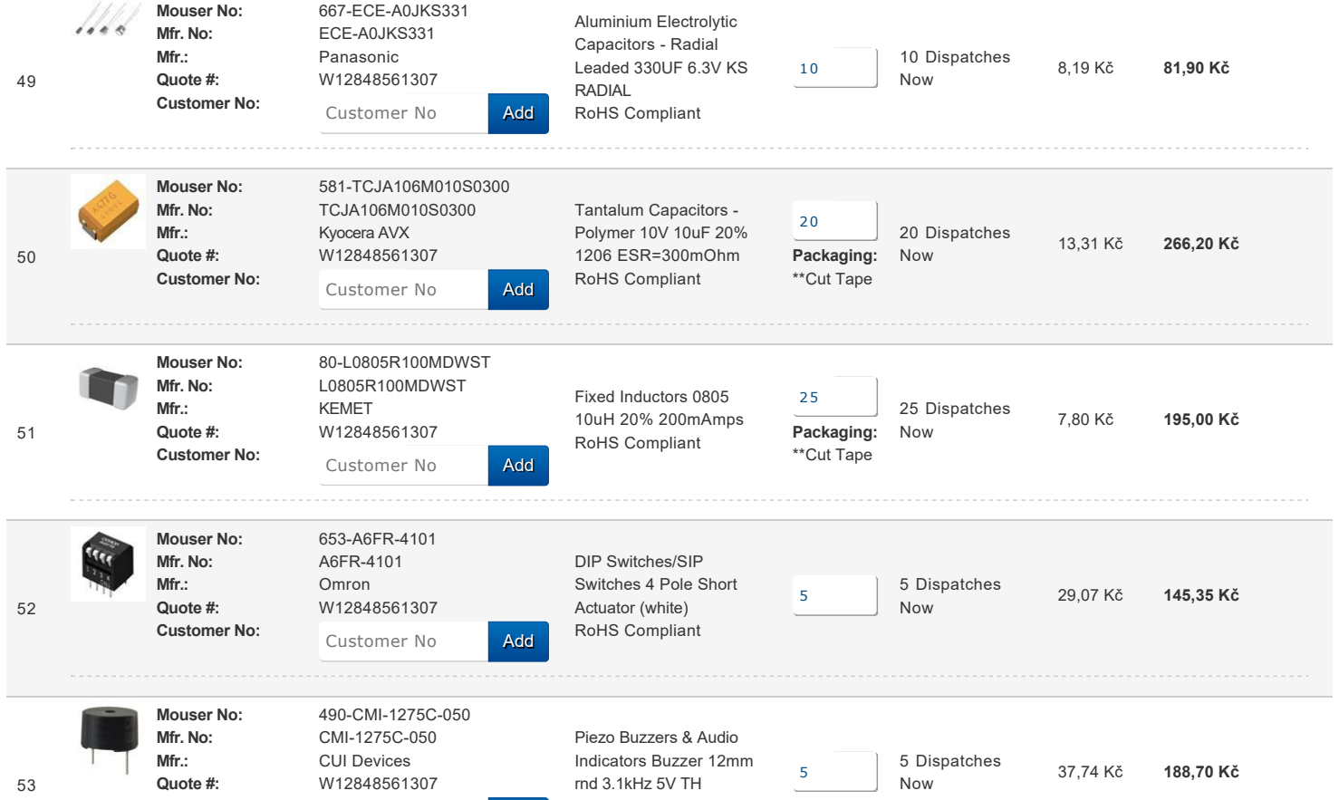
[picture p39: figure]
Mouser No:; 667-ECE-A0JKS331; Mfr. No:; ECE-A0JKS331; Mfr.:; Panasonic; 581-TCJA106M010S0300; TCJA106M010S0300; Kyocera AVX; Quote #:; Customer No:; 80-L0805R100MDWST; L0805R100MDWST; KEMET; Omron; 490-CMI-1275C-050; CMI-1275C-050; CUI Devices; Aluminium Electrolytic; Capacitors Radial; Leaded 330UF 6.3V KS; RADIAL; Tantalum Capacitors; Polymer 10V 10uF 20%; 1206 ESR=300mOhm; RoHS Compliant; Packaging:; **Cut Tape; 20 Dispatches; Now; Fixed Inductors 0805; 10uH 20% 200mAmps; 25 Dispatches; DIP Switches/SIP; Switches 4 Pole Short; Actuator (white); 5 Dispatches; Piezo Buzzers & Audio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
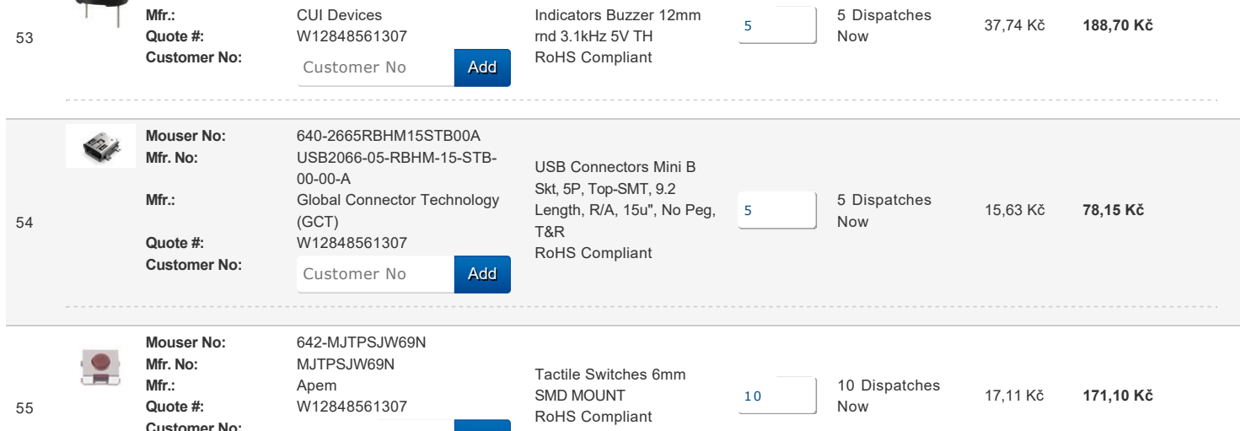
[picture p40: figure]
Customer No:; Mouser No:; 640-2665RBHM15STB00A; Mfr. No:; USB2066-05-RBHM-15-STB-; Mfr.:; Global Connector Technology; (GCT); Quote #:; 642-MJTPSJW69N; MJTPSJW69N; Apem; RoHS Compliant; USB Connectors Mini B; Skt, 5P, Top-SMT, 9.2; Length, R/A, 15u", No Peg,; 5 Dispatches; Now; Tactile Switches 6mm; SMD MOUNT; 10 Dispatches; Customer No; Add

Customer No:

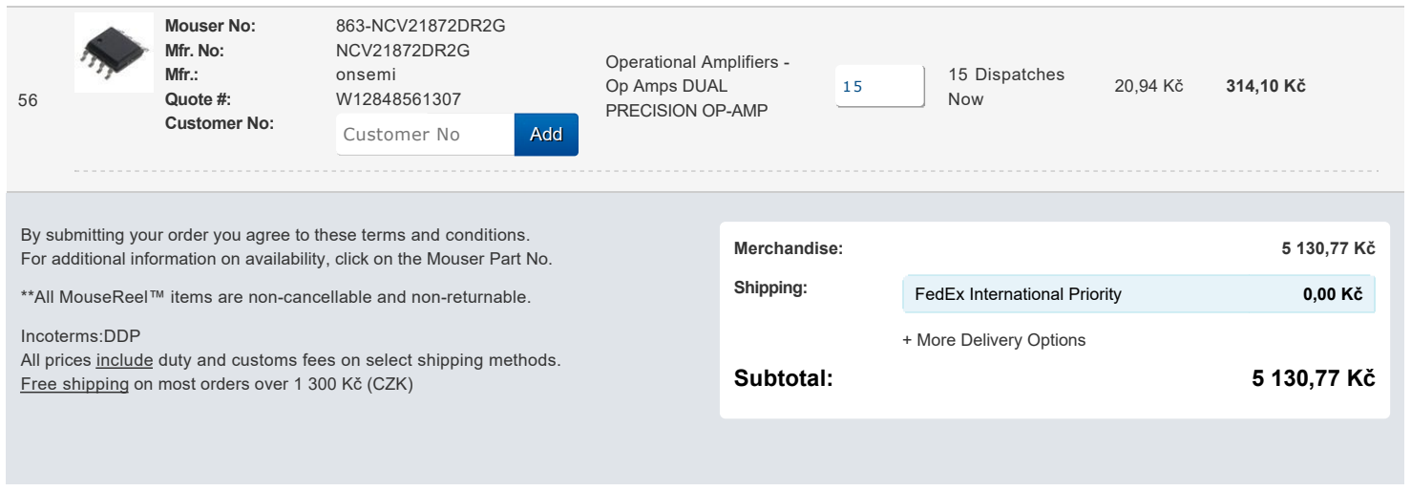
[picture p41: figure]
Mouser No:; 863-NCV21872DR2G; Mfr. No:; NCV21872DR2G; Mfr.:; onsemi; Quote #:; Customer No:; Operational Amplifiers; Op Amps DUAL; PRECISION OP-AMP; 15 Dispatches; Now; Incoterms:DDP; Merchandise:; Shipping:; FedEx International Priority; + More Delivery Options; Subtotal:; Customer No; Add

By submitting your order you agree to these terms and conditions. (https://cz.mouser.com/saleterms) For additional information on availability, click on the Mouser Part No.

**All MouseReel™ items are noncancellable and nonreturnable.

All prices include duty and customs fees on select shipping methods. Free shipping on most orders over 1 300 Kč (CZK)

Customer No | Add
