ItsGoodButStill/IGBS-Rocket-v2/pcb/bom/IGBS-Rocket-v2_rev1_BOM.xlsx

IGBS Rocket v2 (rev1)
 | Množství | Sklad | Hodnota | Název | Pouzdro | Součástky | Popis | Výrobce | Cena | Objednací číslo | Odkaz
 | 1 | 0 | STM32H750VBT6 | STM32H750VBT6 | LQFP100-14X14 | U1 | MCU | STM | 300 Kč | Aliexpress | https://www.aliexpress.com/item/1005003610067060.html?spm=a2g0s.8937460.0.0.7bc42e0etQ6jhz
 | 1 | 0 | BMP280 | BMP280 | BMP280 | B1 | Modul - Barometr | Bosch | 21 Kč | Aliexpress | https://www.aliexpress.com/item/32817286611.html?spm=a2g0o.9042311.0.0.3ccb4c4dT6u8aQ
 | 1 | 5 | ESP-12E/F | ESP-12E/F | ESP-12E | U6 | Modul - ESP WiFi | Espressif | 32 Kč | Aliexpress | https://www.aliexpress.com/item/32256161821.html?spm=a2g0o.9042311.0.0.27424c4dNvsHkl
 | 1 | 1 | GY-NEO6MV2 | GY-NEO6MV2 | GY-NEO6MV2 | B6 | Modul - GPS | U-blox | 68 Kč | Aliexpress | https://www.aliexpress.com/item/1005001635722164.html?spm=a2g0o.9042311.0.0.27424c4dNvsHkl
 | 1 | 1 | ICM-20948 | ICM-20948 | ICM-20948 | B2 | Modul - IMU 9-DOF | InvenSense | 471 Kč | Aliexpress | https://www.aliexpress.com/wholesale?catId=0&initiative_id=SB_20220220032911
 | 3 | 5 | BF350 | BF350 | BF350 | B3, B4, B5 | Modul - Tenzometr | čína | 0 Kč | Aliexpress | https://www.aliexpress.com/item/4000907686535.html?spm=a2g0o.9042311.0.0.27424c4dNvsHkl
 | 1 | 1 | ENC-03 | ENC-03RC | ENC-03RC | Q2 | Gyroskop (analogový 1-osý) | Murata | 115 Kč | 775-043 | https://www.gme.cz/modul-s-jednoosym-gyroskopem-analog-vystup
 | 1 | 0 | MCP6V51T-E/MS | MCP6V51T-E/MS | MSOP8 | U9 | OP Amp (1 kanál, nulovaný) | Microchip | 43 Kč | 579-MCP6V51T-E/MS | https://cz.mouser.com/ProductDetail/Microchip-Technology/MCP6V51T-E-MS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
 | 1 | 0 | LP324DRG4 | LP324DRG4D14 | SOIC-14 | U8 | OP Amp (4 kanál, low-power) | TI | 16 Kč | 595-LP324DRG4 | https://cz.mouser.com/ProductDetail/Texas-Instruments/LP324DRG4?qs=tP77tliwutAatIJd1VAzlA%3D%3D
 | 3 | 0 | NCV21872DR2G | NCV21872DR2G | SOIC-8 | IC1,IC2,IC3 | OP Amp (2 kanál, precision) | Onsemi | 23 Kč | 863-NCV21872DR2G | https://cz.mouser.com/ProductDetail/onsemi/NCV21872DR2G?qs=stqOd1AaK78OxwwfoZPyrA%3D%3D
 | 1 | 0 | 24MHz | OSCILLATOR | SMD-7X5-4PAD | Y1 | Oscilátor | IQD | 40 Kč | 449-LFSPXO018541REEL | https://cz.mouser.com/ProductDetail/IQD/LFSPXO018541Reel?qs=nFovR%252B4R4UOhrXD5yyKlfA%3D%3D
 | 1 | 0 | LM317BD2TG | LM317BD2TG | TO-263-3 | U4 | Regulátor - 3.3 V 1.5A | Onsemi | 57 Kč | 863-LM317BD2TG | https://cz.mouser.com/ProductDetail/onsemi/LM317BD2TG?qs=2OtswVQKCOGYsnJmW5nc7w%3D%3D
 | 1 | 0 | LD1117DT50 | LD1117DT50TRDPAK | TO-252-3 | CR1 | Regulátor - LDO 5V 1A | STM | 15 Kč | 511-LD1117DT50-TR | https://cz.mouser.com/ProductDetail/STMicroelectronics/LD1117DT50TR?qs=ib3vAMMXL5HQnys7jeJYRw%3D%3D
 | 1 | 0 | AZ2185D | AZ2185D-ADJTRG1 | TO-252-3 | CR5 | Regulátor - LDO 6V 3A | Diodes Inc. | 12 Kč | 621-AZ2185D-ADJTRG1 | https://cz.mouser.com/ProductDetail/Diodes-Incorporated/AZ2185D-ADJTRG1?qs=YCa%2FAAYMW022EhXzrDAtDg%3D%3D
 | 1 | 0 | CS5171EDR8G | CS5171EDR8G | SOIC-8 | U3 | DC-DC Boost 12V 1.5 A | Onsemi | 12 Kč | CS5171EDR8G | https://cz.farnell.com/on-semiconductor/cs5171edr8g/dc-dc-conv-280khz-soic-8/dp/2534182?st=cs5171edr8
 | 1 | 0 | BSS316N-H6327 | MOSFET-NCHANNEL | SOT23-3 | Q3 | Tranzistor (N-MOSFET) | Infineon | 10 Kč | 726-BSS316NH6327XT | https://cz.mouser.com/ProductDetail/Infineon-Technologies/BSS316N-H6327?qs=oPPfIaWL1l1TH2bME9QMJw%3D%3D
 | 1 | 0 | BSS314PE H6327 | MOSFET-PCHANNEL | SOT23-3 | Q5 | Tranzistor (P-MOSFET) | Infineon | 10 Kč | 726-BSS314PEH6327XT | https://cz.mouser.com/ProductDetail/Infineon-Technologies/BSS314PEH6327XT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
 | 2 | 0 | BC817 | BC817-16LT1SMD | SOT23-BEC | Q1 | Tranzistor (NPN) | NXP | 5 Kč | 771-BC817-40-T/R | https://cz.mouser.com/ProductDetail/Nexperia/BC817-40215
 | 1 | 0 | 1N4148 | DIODESOD123 | SOD-123 | D16 | Dioda | Vishay | 8 Kč | 78-1N4148W-G3-08 | https://cz.mouser.com/ProductDetail/Vishay-Semiconductors/1N4148W-G3-08?qs=uS%252BVSIFnvp46StDBB15x4Q%3D%3D
 | 1 | 0 | SS12 | DIODE SHOTTKY | DO-214 | CR16 | Shottkyho dioda | Onsemi | 9 Kč | 512-SS12 | https://cz.mouser.com/ProductDetail/onsemi-Fairchild/SS12?qs=mVVXn4M53U9WoaEpU1CO0A%3D%3D
 | 3 | 0 | 3V6 | DIODE-ZENER | SOD-123 | D14, D15 | Zenerova dioda 3.6V | NXP | 6 Kč | 771-BZT52-B3V6X | https://cz.mouser.com/ProductDetail/Nexperia/BZT52-B3V6X?qs=W0yvOO0ixfGYHfMgmHmlFg%3D%3D
 | 3 | 0 | TS4040DILT-2.5 | REF2.5 | SOT-23-3 | CR2,CR3,CR4 | Reference 2.5V | STM | 18 Kč | 511-TS4040DILT-2.5 | https://cz.mouser.com/ProductDetail/STMicroelectronics/TS4040DILT-25?qs=oLWruFkFDtbWiHUxOo5Lpg%3D%3D
 | 1 | 0 | 10V | VARISTORCN0805 | CT/CN0805 | MOV1 | Varistor | AVX | 9.38 Kč | 581-VCUG080100L1DP | https://cz.mouser.com/ProductDetail/Kyocera-AVX/VCUG080100L1DP?qs=4b8myOmUP%252BvFvY7HP%2FE81g%3D%3D
 | 1 | 0 | TVSSMA | TVSSMA | SMA-DIODE | D7 | TVS (transil) | Diodes Inc. | 11 Kč | 621-SMAJ12AQ-13-F | https://cz.mouser.com/ProductDetail/Diodes-Incorporated/SMAJ12AQ-13-F?qs=17u8i%2FzlE89YHZfVTZAJbg%3D%3D
 | 1 | 0 | 10V/5.5A | PPTC_6V2A | PPTC-1210 | PPTC1 | Resetovatelná pojistka (PPTC) | Bourns | 19 Kč | 652-MF-USML250-2 | https://cz.mouser.com/ProductDetail/Bourns/MF-USML250-2?qs=GQB1MWV6WHUugjN971hOoA%3D%3D
 | 1 | 0 | red | LED-1206 | LED-1206 | D11 | LED (červená) - app 3 | Kingsbright | 7 Kč | 604-APTR3216SURCK | https://cz.mouser.com/ProductDetail/Kingbright/APTR3216SURCK?qs=JpELLRhtMc0eQGI0N2RR4A%3D%3D
 | 2 | 0 | blue | LED-1206 | LED-1206 | D5 | LED (modrá) - app 1,4 | Kingsbright | 11 Kč | 604-APT3216LVBCD | https://cz.mouser.com/ProductDetail/Kingbright/APT3216LVBC-D?qs=6oMev5NRZMHkh%2FkgOlUYsw%3D%3D
 | 4 | 0 | orange | LED-1206 | LED-1206 | D9, D10, D12, D13 | LED (oranžová) - baterie | Kingsbright | 6 Kč | 604-APTR3216SECK | https://cz.mouser.com/ProductDetail/Kingbright/APTR3216SECK?qs=JpELLRhtMc3MdVPKgqg2EA%3D%3D
 | 4 | 0 | green | LED-1206 | LED-1206 | D1, D2, D3, D4 | LED (zelená) - PSU | Kingsbright | 9 Kč | 604-APTR3216CGCK | https://cz.mouser.com/ProductDetail/Kingbright/APTR3216CGCK?qs=VdjlWU%2FzoOEEylQIF4ri%2FA%3D%3D
 | 1 | 0 | yellow | LED-1206 | LED-1206 | D6 | LED (žlutá) - app 2 | Kingsbright | 11 Kč | 604-APTR3216SYC | https://cz.mouser.com/ProductDetail/Kingbright/APTR3216SYC?qs=SxaZfIVsCL1Ylrio%252BpkOEg%3D%3D
 | 3 | 0 | 500k | R-TRIMM-SMD | 3.6x3.6x2.0 | R4,R68,R77 | Trimmer (20%) | Bourns | 31 Kč | 81-PVG3A504C01R00 | https://cz.mouser.com/ProductDetail/Bourns/PVG3A504C01R00
 | 2 | 0 | 100k | R-EU_R0603 | R0603 | R48, R59 | Rezistor (1%) | Bourns | 2 Kč | 652-CR0603-FX-103ELF | https://cz.mouser.com/ProductDetail/Bourns/CR0603-FX-1003ELF
 | 18 | 0 | 10k | R-EU_R0603 | R0603 | R14, R15, R16, R17, R27, R29, R30, R32, R36, R39, R40, R49, R50, R51, R52 | Rezistor (1%) | Bourns | 2 Kč | 652-CR0603FX-1002ELF | https://cz.mouser.com/ProductDetail/Bourns/CR0603-FX-1002ELF
 | 2 | 0 | 12k | R-EU_R0603 | R0603 | R38, R42 | Rezistor (1%) | Bourns | 2 Kč | 652-CR0603FX-1202ELF | https://cz.mouser.com/ProductDetail/Bourns/CR0603-FX-1202ELF
 | 2 | 0 | 150R | R-EU_R0603 | R0603 | R1, R4 | Rezistor (1%) | Vishay | 2 Kč | 71-CRCW0603150RFKEBC | https://cz.mouser.com/ProductDetail/Vishay-Dale/CRCW0603150RFKEBC
 | 9 | 0 | 1K | R-EU_R0603 | R0603 | R10, R19, R20, R21, R25, R26, R28, R57 | Rezistor (1%) | Vishay | 2 Kč | 71-CRCW06031K00FKEAC | https://cz.mouser.com/ProductDetail/Vishay-Dale/CRCW06031K00FKEAC
 | 6 | 0 | 1K5 | R-EU_R0603 | R0603 | R7, R18, R31, R34, R35, R54 | Rezistor (1%) | Bourns | 2 Kč | 652-CR0603FX-1501ELF | https://cz.mouser.com/ProductDetail/Bourns/CR0603-FX-1501ELF
 | 1 | 0 | 1K27 | R-EU_R0603 | R0603 | R88 | Rezistor (1%) | Bourns | 2 Kč | 652-CR0603FX-1271ELF | https://cz.mouser.com/ProductDetail/Bourns/CR0603-FX-1271ELF?qs=e7cxVwPieurA8a1rkwpi9g%3D%3D
 | 2 | 0 | 1K8 | R-EU_R0603 | R0603 | R3, R6 | Rezistor (1%) | Vishay | 2 Kč | 71-CRCW06031K80FKEAC | https://cz.mouser.com/ProductDetail/Vishay-Dale/CRCW06031K80FKEAC
 | 3 | 0 | 20k | R-EU_R0603 | R0603 | R65,R74,R83 | Rezistor (1%) | Vishay | 2 Kč | 71-CRCW060320K0FKEAC | https://cz.mouser.com/ProductDetail/Vishay-Dale/CRCW060320K0FKEAC
 | 7 | 0 | 22R | R-EU_R0603 | R0603 | R11, R12, R13, R22, R23, R24, R58 | Rezistor (1%) | Bourns | 2 Kč | 652-CR0603FX-22R0ELF | https://cz.mouser.com/ProductDetail/Bourns/CR0603-FX-22R0ELF
 | 1 | 0 | 240R | R-EU_R0603 | R0603 | R8 | Rezistor (1%) | YAGEO | 2 Kč | 603-RC0603FR-13240RL | https://cz.mouser.com/ProductDetail/YAGEO/RC0603FR-13240RL
 | 1 | 0 | 3k6 | R-EU_R0603 | R0603 | R86 | Rezistor (1%) | Bourns | 2 Kč | 652-CR0603FX-3602ELF | https://cz.mouser.com/ProductDetail/Bourns/CR0603-FX-3602ELF?qs=CCIlxZRRv7hmDpW5L1G8Vg%3D%3D
 | 1 | 0 | 30k | R-EU_R0603 | R0603 | R94 | Rezistor (1%) | Bourns | 2 Kč | 652-CR0603FX-3002ELF | https://cz.mouser.com/ProductDetail/Bourns/CR0603-FX-3002ELF?qs=I4suiNu8FYASKlbXph1m%252BQ%3D%3D
 | 3 | 0 | 330R | R-EU_R0603 | R0603 | R67,R76,R85 | Rezistor (1%) | Bourns | 2 Kč | 652-CR0603FX-3300ELF | https://cz.mouser.com/ProductDetail/Bourns/CR0603-FX-3300ELF
 | 9 | 0 | 360R | R-EU_R0603 | R0603 | R63,R6,R62,R72,R70,R71,R81,R79,R80 | Rezistor (1%) | Bourns | 2 Kč | 652-CR0603FX-3600ELF | https://cz.mouser.com/ProductDetail/Bourns/CR0603-FX-3600ELF
 | 1 | 0 | 390R | R-EU_R0603 | R0603 | R9 | Rezistor (1%) | Bourns | 2 Kč | 652-CR0603FX-3900ELF | https://cz.mouser.com/ProductDetail/Bourns/CR0603-FX-3900ELF
 | 4 | 0 | 47k | R-EU_R0603 | R0603 | R44, R45, R46, R47 | Rezistor (1%) | Bourns | 2 Kč | 652-CR0603FX-4702ELF | https://cz.mouser.com/ProductDetail/Bourns/CR0603-FX-4702ELF
 | 2 | 0 | 4k7 | R-EU_R0603 | R0603 | R55, R56 | Rezistor (1%) | Bourns | 2 Kč | 652-CR0603FX-4701ELF | https://cz.mouser.com/ProductDetail/Bourns/CR0603-FX-4701ELF
 | 1 | 0 | 4k87 | R-EU_R0603 | R0603 | R87 | Rezistor (1%) | Bourns | 2 Kč | 652-CR0603FX-4871ELF | https://cz.mouser.com/ProductDetail/Bourns/CR0603-FX-4871ELF?qs=0nF2VnfAjXntrGMjzb7egA%3D%3D
 | 3 | 0 | 470k | R-EU_R0603 | R0603 | R66,R75,R84 | Rezistor (1%) | Bourns | 2 Kč | 652-CR0603FX-4703ELF | https://cz.mouser.com/ProductDetail/Bourns/CR0603-FX-4703ELF
 | 1 | 0 | 5k | R-EU_R0603 | R0603 | R89 | Rezistor (1%) | Vishay | 2 Kč | 71-CRCW0603-5.05K-E3 | https://cz.mouser.com/ProductDetail/Vishay-Dale/CRCW06035K05FKEA
 | 2 | 0 | 560R | R-EU_R0603 | R0603 | R2, R5 | Rezistor (1%) | YAGEO | 2 Kč | 603-RC0603FR-07560RL | https://cz.mouser.com/ProductDetail/YAGEO/RC0603FR-07560RL?qs=sGAEpiMZZMvdGkrng054t9aoOLKp3QiTMKXmTLwiJck%3D
 | 2 | 0 | 6k8 | R-EU_R0603 | R0603 | R33, R43 | Rezistor (1%) | Bourns | 2 Kč | 652-CR0603FX-6801ELF | https://cz.mouser.com/ProductDetail/Bourns/CR0603-FX-6801ELF
 | 1 | 0 | 59k (75k, 90k) | R-EU_R0603 | R0603 | R53 | Rezistor (1%) - Gyro Amp | Bourns | 2 Kč | 652-CR0603FX-5902ELF | https://cz.mouser.com/ProductDetail/Bourns/CR0603-FX-5902ELF
 | 1 | 0 | 7k5 | R-EU_R0603 | R0603 | R37 | Rezistor (1%) | Bourns | 2 Kč | 652-CR0603FX-7501ELF | https://cz.mouser.com/ProductDetail/Bourns/CR0603-FX-7501ELF
 | 1 | 0 | 9k1 | R-EU_R0603 | R0603 | R41 | Rezistor (1%) | Bourns | 2 Kč | 652-CR0603FX-9101ELF | https://cz.mouser.com/ProductDetail/Bourns/CR0603-FX-9101ELF?qs=Ody%252BWaR0NcGQ1E6X8Qod4w%3D%3D
 | 1 | 0 | 10n | C-EUC0603K | C0603K | C47 | Kondenzátor (MLCC) X7R 50V | AVX | 2 Kč | 581-06035C103K | https://cz.mouser.com/ProductDetail/Kyocera-AVX/06035C103KAT2A
 | 18 | 0 | 100n | C-EUC0603K | C0603K | C4, C11, C12, C13, C14, C15, C18, C20, C21, C22, C23, C25, C29, C33, C36 | Kondenzátor (MLCC) X7R 50V | AVX | 2 Kč | 581-06035C104KAT2A | https://cz.mouser.com/ProductDetail/Kyocera-AVX/06035C104KAT2A?qs=wORnlwVG%2F0dQ8Y%2FnMEnCGg%3D%3D
 | 9 | 0 | 1u | C-EUC0603K | C0603K | C8,C34,C30,C37,C39,C38,C41,C43,C42 | Kondenzátor (MLCC) X7R 16V | AVX | 4 Kč | 581-0603YC105KAT2A | https://cz.mouser.com/ProductDetail/Kyocera-AVX/0603YC105KAT2A?qs=oZHZyJ9sPsF0nYEZ1SOhJA%3D%3D
 | 1 | 0 | 1u8 | C-EUC0805K | C0805K | C28 | Kondenzátor (MLCC) X7R 16V | Kemet | 16 Kč | 80-C0805C185K4R | https://cz.mouser.com/ProductDetail/KEMET/C0805C185K4RACTU?qs=jGANiKWBgcgMt3MxQlQZew%3D%3D
 | 2 | 0 | 2u2 | C-EUC0603K | C0603K | C16, C17 | Kondenzátor (MLCC) X7R 16V | Samsung | 3 Kč | 187-CL21B225KOFNFNE | https://cz.mouser.com/ProductDetail/Samsung-Electro-Mechanics/CL21B225KOFNFNE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
 | 2 | 0 | 4u7 | C-EUC0603K | C0603K | C26, C27 | Kondenzátor (MLCC) X7R 16V | Murata | 4 Kč | 81-GRM21BR71C475KE1L | https://cz.mouser.com/ProductDetail/Murata-Electronics/GRM21BR71C475KE51L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
 | 9 | 0 | 10u | 10UF10V10%(0805) | 0805-CAP | C2, C3, C5, C7, C9, C19, C24, C30, C31 | Kondenzátor (MLCC) X7R 16V | Murata | 4 Kč | 81-GRM21BR61C106KE5K | https://cz.mouser.com/ProductDetail/Murata-Electronics/GRM21BR61C106KE15K?qs=h0WOCFF19ULjTOS37upAEw%3D%3D
 | 2 | 0 | 22u | 10UF10V20%(0805) | 0805-CAP | C44, C46 | Kondenzátor (MLCC) X5R 24V | Murata | 10 Kč | 81-GRM21BR61E226ME4K | https://cz.mouser.com/ProductDetail/Murata-Electronics/GRM21BR61E226ME44K?qs=hNud%2FORuBR25jDsUehWlrQ%3D%3D
 | 1 | 0 | 680u | CPOL-EUTT2D7L | TT2D7L | C1 | Kondenzátor (polarizovaný) | Rubycon | 12 Kč | 232-16ZLH680MEFC8X16 | https://cz.mouser.com/ProductDetail/Rubycon/16ZLH680MEFC8X16?qs=T3oQrply3y%252BxYyHxA7I8ow%3D%3D
 | 1 | 0 | 330u | CPOL-EUTT2D7L | TT2D7L | C32 | Kondenzátor (polarizovaný) | Panasonic | 11 Kč | 667-ECE-A0JKS331 | https://cz.mouser.com/ProductDetail/Panasonic/ECE-A0JKS331?qs=rMMd5vBiahoH7l%2FK37Tb1w%3D%3D
 | 3 | 0 | 10u Tant | CPOL-EUCT3216 | CT3216 | C6, C8, C10 | Kondenzátor (Tantal) | AVX | 13 Kč | 581-TCJA106M010S0300 | https://cz.mouser.com/ProductDetail/Wurth-Elektronik/74437346220?qs=cFlH0mFHHFpTwVP0RKnhAQ%3D%3D (https://cz.mouser.com/ProductDetail/Kyocera-AVX/TCJA106M010S0300?qs=QtI0yD1FyOM69i8ZMiLJxA%3D%3D)
 | 4 | 0 | 10uH | INDUCTOR0603 | R0603 | L1, L2, L3, L4 | Tlumivka | Kemet | 10 Kč | 80-L0805R100MDWST | https://cz.mouser.com/ProductDetail/KEMET/L0805R100MDWST?qs=e0j0OS9oV9qUk1EH9zXw7A%3D%3D
1 | 1 | 0 | 22uH | POWER INDUCTOR | PWR INDUCT | L5 | Boost Pwr Cívka | Wurth | 50 Kč | 710-74437346220 | https://cz.mouser.com/ProductDetail/Wurth-Elektronik/74437346220?qs=cFlH0mFHHFpTwVP0RKnhAQ%3D%3D
 | 1 | 0 | MICROSD | MICROSD-PUSH-OUT | MICROSD | U5 | Slot pro mikro-SD kartu | čína | 5 Kč | Aliexpress | https://www.aliexpress.com/item/32802051702.html?spm=a2g0o.9042311.0.0.27424c4dNvsHkl
 | 1 | 0 | piano | A6FR-4101SW | A6FR-4101 | PIANO | Piáno (4-kanál) | Omron | 29 Kč | 653-A6FR-4101 | https://cz.mouser.com/ProductDetail/Omron-Electronics/A6FR-4101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
 | 2 | 0 | button | B3FS-1000SW | B3FS-1000 | BTN1, RESET | Tlačítko | Apem | 19 Kč | 642-MJTPSJW69N | https://cz.mouser.com/ProductDetail/Apem/MJTPSJW69N?qs=%2Fs1LKTamv0yeZkxrSYaN4A%3D%3D
 | 1 | 0 | BUZZERPTH | BUZZERPTH | BUZZER-12MM | BUZZER | Buzzer (piezo, 12mm) | CUI | 37 Kč | 490-CMI-1275C-050 | https://cz.mouser.com/ProductDetail/CUI-Devices/CMI-1275C-050?qs=qCxwlXJ4fnyWvfqXc%252BNqAA%3D%3D
 | 1 | 0 | USB-MINIB-5PIN | USB-MINIB-5PIN | USB-MINIB | USB | USB konektor (mini) | GCT | 15 Kč | 640-2665RBHM15STB00A | https://cz.mouser.com/ProductDetail/GCT/USB2066-05-RBHM-15-STB-00-00-A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
 | 1 | 0 | S2B-PH-K-S | S2B-PH-K-S | CONN_S2B-PH | PWR-B | JST konektor (baterie) | JST | 5 Kč | Aliexpress | https://www.aliexpress.com/item/1005003115054198.html?spm=a2g0o.productlist.0.0.3dce56b03IVFEp
 | 4 | 0 | S2B-XH-A | S2B-XH-A | CONN_S2B-XH | MAG | JST konektor (magnet, 3 tenz.) | JST | 5 Kč | Aliexpress | https://www.aliexpress.com/item/1005003115054198.html?spm=a2g0o.productlist.0.0.3dce56b03IVFEp
 | 4 | 0 | S3B-XH-A | S3B-XH-A | CONN_S3B-XH | SRV1-A, SRV1-B, SRV2-A, SRV2-B | JST konektor (serva) | JST | 5 Kč | Aliexpress | https://www.aliexpress.com/item/1005003115054198.html?spm=a2g0o.productlist.0.0.3dce56b03IVFEp
 | 1 | 0 | XT30PW-M | XT30PW-M | XT30PW-M | PWR-A | XT30 konektor (baterie) | AMASS | 15 Kč | XT30PW-M | https://www.tme.eu/cz/details/xt30pw-m/konektory-dc/amass/
 |  |  |  |  |  |  |  | cena 1 PCB: | 2290.38 Kč
 |  |  |  |  |  |  |  | x5: | 11451.9 Kč
 | Legenda: |  |  | Neobjednáno |  |  |  | Aliexpress: | 892 Kč
 |  |  |  | Není dostupné |  |  |  | Aiexpress x5: | 4460 Kč
 |  |  |  | Na cestě
 |  |  |  | Skladem
 |  |  |  | Nutno doobjednat |  |  |  | Others: | 1283.38 Kč
 |  |  |  |  |  |  |  | Others x5: | 6416.9 Kč
 | Legenda 2: |  |  | Mouser
 |  |  |  | Farnell
 |  |  |  | GME Praha Karlín
 |  |  |  | Aliexpress
 |  |  |  | 579-MCP6V51T-E/MS |  | 5 | 1
 |  |  |  | 595-LP324DRG4 |  | 5 | 1
 |  |  |  | NCV21872DR2G |  | 15 | 3
 |  |  |  | 449-LFSPXO018541REEL |  | 5 | 1
 |  |  |  | 863-LM317BD2TG |  | 5 | 1
 |  |  |  | 511-LD1117DT50-TR |  | 5 | 1
 |  |  |  | 621-AZ2185D-ADJTRG1 |  | 5 | 1
 |  |  |  | 726-BSS316NH6327XT |  | 5 | 1
 |  |  |  | 771-BC817-40-T/R |  | 5 | 1
 |  |  |  | 78-1N4148W-G3-08 |  | 5 | 1
 |  |  |  | 771-BZT52-B3V6X |  | 15 | 3
 |  |  |  | 511-TS4040DILT-2.5 |  | 15 | 3
 |  |  |  | 581-VCUG080100L1DP |  | 5 | 1
 |  |  |  | 621-SMAJ12AQ-13-F |  | 5 | 1
 |  |  |  | 652-MF-USML250-2 |  | 5 | 1
 |  |  |  | 604-APTR3216SURCK |  | 5 | 1
 |  |  |  | 604-APT3216LVBCD |  | 10 | 2
 |  |  |  | 604-APTR3216SECK |  | 20 | 4
 |  |  |  | 604-APTR3216CGCK |  | 20 | 4
 |  |  |  | 604-APTR3216SYC |  | 5 | 1
 |  |  |  | 81-PVG3A504C01R00 |  | 15 | 3
 |  |  |  | 652-CR0603-FX-103ELF |  | 10 | 2
 |  |  |  | 652-CR0603FX-1002ELF |  | 90 | 18
 |  |  |  | 652-CR0603FX-1202ELF |  | 10 | 2
 |  |  |  | 71-CRCW0603150RFKEBC |  | 10 | 2
 |  |  |  | 71-CRCW06031K00FKEAC |  | 45 | 9
 |  |  |  | 652-CR0603FX-1501ELF |  | 30 | 6
 |  |  |  | 71-CRCW06031K80FKEAC |  | 10 | 2
 |  |  |  | 71-CRCW060320K0FKEAC |  | 15 | 3
 |  |  |  | 652-CR0603FX-22R0ELF |  | 35 | 7
 |  |  |  | 603-RC0603FR-13240RL |  | 5 | 1
 |  |  |  | 652-CR0603FX-3300ELF |  | 15 | 3
 |  |  |  | 652-CR0603FX-3600ELF |  | 45 | 9
 |  |  |  | 652-CR0603FX-3900ELF |  | 5 | 1
 |  |  |  | 652-CR0603FX-4702ELF |  | 20 | 4
 |  |  |  | 652-CR0603FX-4701ELF |  | 10 | 2
 |  |  |  | 652-CR0603FX-4703ELF |  | 15 | 3
 |  |  |  | 603-RC0603FR-07560RL |  | 10 | 2
 |  |  |  | 652-CR0603FX-6801ELF |  | 10 | 2
 |  |  |  | 652-CR0603FX-5902ELF |  | 5 | 1
 |  |  |  | 652-CR0603FX-7501ELF |  | 5 | 1
 |  |  |  | 652-CR0603FX-9101ELF |  | 5 | 1
 |  |  |  | 581-06035C104KAT2A |  | 90 | 18
 |  |  |  | 581-0603YC105KAT2A |  | 45 | 9
 |  |  |  | 80-C0805C185K4R |  | 5 | 1
 |  |  |  | 187-CL21B225KOFNFNE |  | 10 | 2
 |  |  |  | 81-GRM21BR71C475KE1L |  | 10 | 2
 |  |  |  | 81-GRM21BR61C106KE5K |  | 45 | 9
 |  |  |  | 232-16ZLH680MEFC8X16 |  | 5 | 1
 |  |  |  | 667-ECE-A0JKS331 |  | 5 | 1
 |  |  |  | 581-TCJA106M010S0300 |  | 15 | 3
 |  |  |  | 80-L0805R100MDWST |  | 20 | 4
 |  |  |  | 653-A6FR-4101 |  | 5 | 1
 |  |  |  | 490-CMI-1275C-050 |  | 5 | 1
 |  |  |  | 640-2665RBHM15STB00A |  | 5 | 1
 |  |  |  | 642-MJTPSJW69N |  | 5 | 1
