ItsGoodButStill/IGBS-Rocket-v2/pcb/dxf/IGBS-Rocket-v2_rev1_bot.dxf

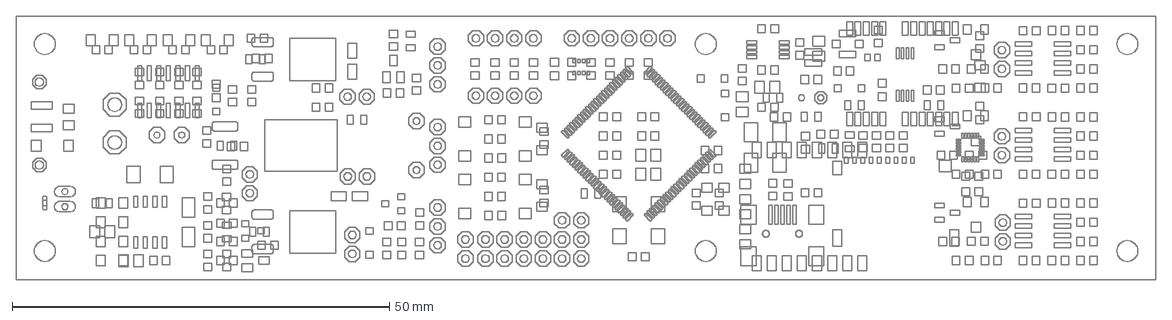
[picture p42: CAD file, 2022-03-26]
pcb/dxf/IGBS-Rocket-v2_rev1_bot.dxf
151.1 x 34.9 mm
