ItsGoodButStill/IGBS-Rocket-v2/pcb/dxf/IGBS-Rocket-v2_rev1_top.dxf

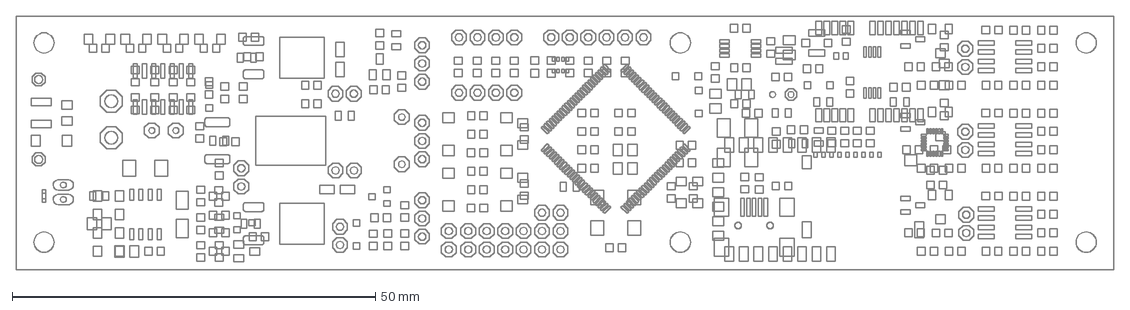
[picture p43: CAD file, 2022-03-26]
pcb/dxf/IGBS-Rocket-v2_rev1_top.dxf
151.1 x 34.9 mm
