ItsGoodButStill/IGBS-Rocket-v2/pcb/IGBS-Rocket-v2_PCB_rev1/IGBS-Rocket-v2_rev1.brd

## EAGLE design pcb/IGBS-Rocket-v2_PCB_rev1/IGBS-Rocket-v2_rev1.brd (2022-04-18)

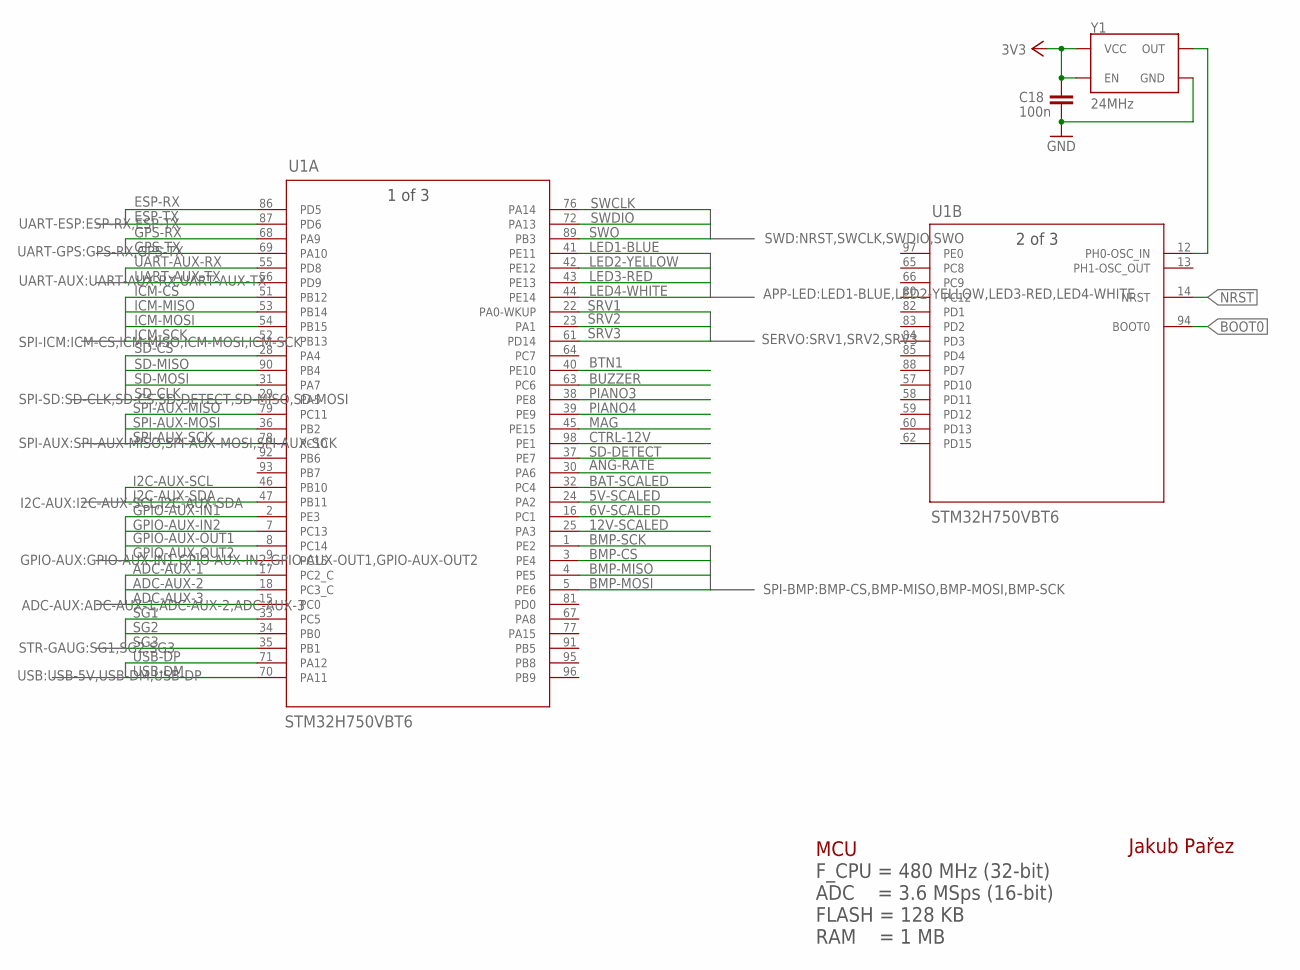
[picture p55: schematic IGBS-Rocket-v2_rev1.sch, sheet 1, MCU]

Parts:
C18: 100n; C0603K
U1: STM32H750VBT6; LQFP100-14X14MM
Y1: 24MHz; OSCILLATOR-SMD-7X5-4PAD

Connections:
3V3: C18.2, Y1.1 (EN), Y1.4 (VCC); also elsewhere on the board
5V-SCALED: U1.24 (PA2); also elsewhere on the board
6V-SCALED: U1.16 (PC1); also elsewhere on the board
12V-SCALED: U1.25 (PA3); also elsewhere on the board
ADC-AUX-1: U1.17 (PC2_C); also elsewhere on the board
ADC-AUX-2: U1.18 (PC3_C); also elsewhere on the board
ADC-AUX-3: U1.15 (PC0); also elsewhere on the board
ANG-RATE: U1.30 (PA6); also elsewhere on the board
BAT-SCALED: U1.32 (PC4); also elsewhere on the board
BMP-CS: U1.3 (PE4); also elsewhere on the board
BMP-MISO: U1.4 (PE5); also elsewhere on the board
BMP-MOSI: U1.5 (PE6); also elsewhere on the board
BMP-SCK: U1.1 (PE2); also elsewhere on the board
BOOT0: U1.94 (BOOT0); also elsewhere on the board
BTN1: U1.40 (PE10); also elsewhere on the board
BUZZER: U1.63 (PC6); also elsewhere on the board
CTRL-12V: U1.98 (PE1); also elsewhere on the board
ESP-RX: U1.86 (PD5); also elsewhere on the board
ESP-TX: U1.87 (PD6); also elsewhere on the board
GND: C18.1, Y1.2 (GND); also elsewhere on the board
GPIO-AUX-IN1: U1.2 (PE3); also elsewhere on the board
GPIO-AUX-IN2: U1.7 (PC13); also elsewhere on the board
GPIO-AUX-OUT1: U1.8 (PC14); also elsewhere on the board
GPIO-AUX-OUT2: U1.9 (PC15); also elsewhere on the board
GPS-RX: U1.68 (PA9); also elsewhere on the board
GPS-TX: U1.69 (PA10); also elsewhere on the board
I2C-AUX-SCL: U1.46 (PB10); also elsewhere on the board
I2C-AUX-SDA: U1.47 (PB11); also elsewhere on the board
ICM-CS: U1.51 (PB12); also elsewhere on the board
ICM-MISO: U1.53 (PB14); also elsewhere on the board
ICM-MOSI: U1.54 (PB15); also elsewhere on the board
ICM-SCK: U1.52 (PB13); also elsewhere on the board
LED1-BLUE: U1.41 (PE11); also elsewhere on the board
LED2-YELLOW: U1.42 (PE12); also elsewhere on the board
LED3-RED: U1.43 (PE13); also elsewhere on the board
LED4-WHITE: U1.44 (PE14); also elsewhere on the board
MAG: U1.45 (PE15); also elsewhere on the board
unnamed: U1.12 (PH0-OSC_IN), Y1.3 (OUT)
NRST: U1.14 (NRST); also elsewhere on the board
PIANO3: U1.38 (PE8); also elsewhere on the board
PIANO4: U1.39 (PE9); also elsewhere on the board
SD-CLK: U1.29 (PA5); also elsewhere on the board
SD-CS: U1.28 (PA4); also elsewhere on the board
SD-DETECT: U1.37 (PE7); also elsewhere on the board
SD-MISO: U1.90 (PB4); also elsewhere on the board
SD-MOSI: U1.31 (PA7); also elsewhere on the board
SG1: U1.33 (PC5); also elsewhere on the board
SG2: U1.34 (PB0); also elsewhere on the board
SG3: U1.35 (PB1); also elsewhere on the board
SPI-AUX-MISO: U1.79 (PC11); also elsewhere on the board
SPI-AUX-MOSI: U1.36 (PB2); also elsewhere on the board
SPI-AUX-SCK: U1.78 (PC10); also elsewhere on the board
SRV1: U1.22 (PA0-WKUP); also elsewhere on the board
SRV2: U1.23 (PA1); also elsewhere on the board
SRV3: U1.61 (PD14); also elsewhere on the board
SWCLK: U1.76 (PA14); also elsewhere on the board
SWDIO: U1.72 (PA13); also elsewhere on the board
SWO: U1.89 (PB3); also elsewhere on the board
UART-AUX-RX: U1.55 (PD8); also elsewhere on the board
UART-AUX-TX: U1.56 (PD9); also elsewhere on the board
USB-DM: U1.70 (PA11); also elsewhere on the board
USB-DP: U1.71 (PA12); also elsewhere on the board

Notes on the sheet:
MCU
Jakub Pařez
F_CPU = 480 MHz (32-bit) ADC = 3.6 MSps (16-bit) FLASH = 128 KB RAM = 1 MB

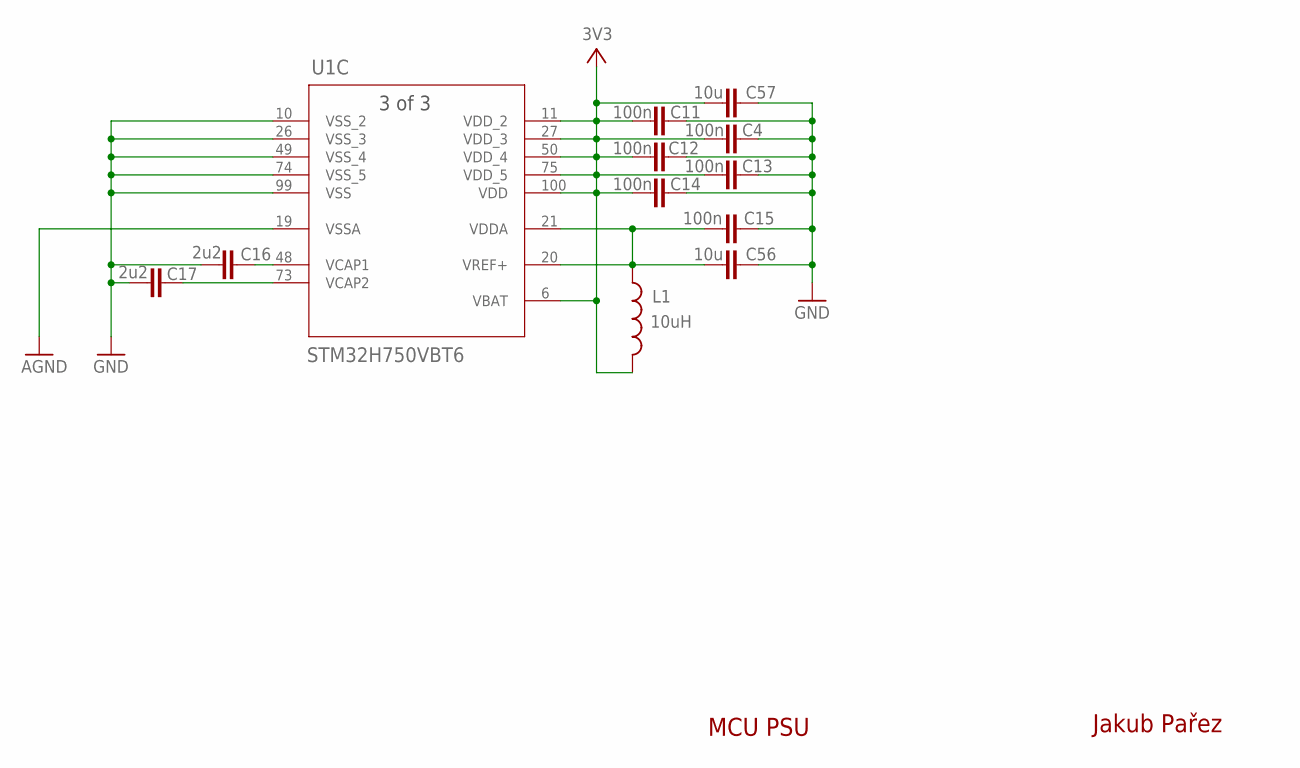
[picture p56: schematic IGBS-Rocket-v2_rev1.sch, sheet 2, MCU PSU]

Parts:
C4, C11, C12, C13, C14, C15: 100n; C0603K
C16, C17: 2u2; C0805K
C56, C57: 10u; 0805-CAP
L1: 10uH; 0805
U1: STM32H750VBT6; LQFP100-14X14MM

Connections:
3V3: C4.2, C11.2, C12.2, C13.2, C14.2, C57.1, L1.2, U1.6 (VBAT), U1.11 (VDD_2), U1.27 (VDD_3), U1.50 (VDD_4), U1.75 (VDD_5), U1.100 (VDD); also elsewhere on the board
AGND: U1.19 (VSSA)
GND: C4.1, C11.1, C12.1, C13.1, C14.1, C15.1, C16.2, C17.1, C56.2, C57.2, U1.10 (VSS_2), U1.26 (VSS_3), U1.49 (VSS_4), U1.74 (VSS_5), U1.99 (VSS); also elsewhere on the board
unnamed: C16.1, U1.48 (VCAP1)
unnamed: C17.2, U1.73 (VCAP2)
VDDA: C15.2, C56.1, L1.1, U1.20 (VREF+), U1.21 (VDDA)

Notes on the sheet:
MCU PSU
Jakub Pařez

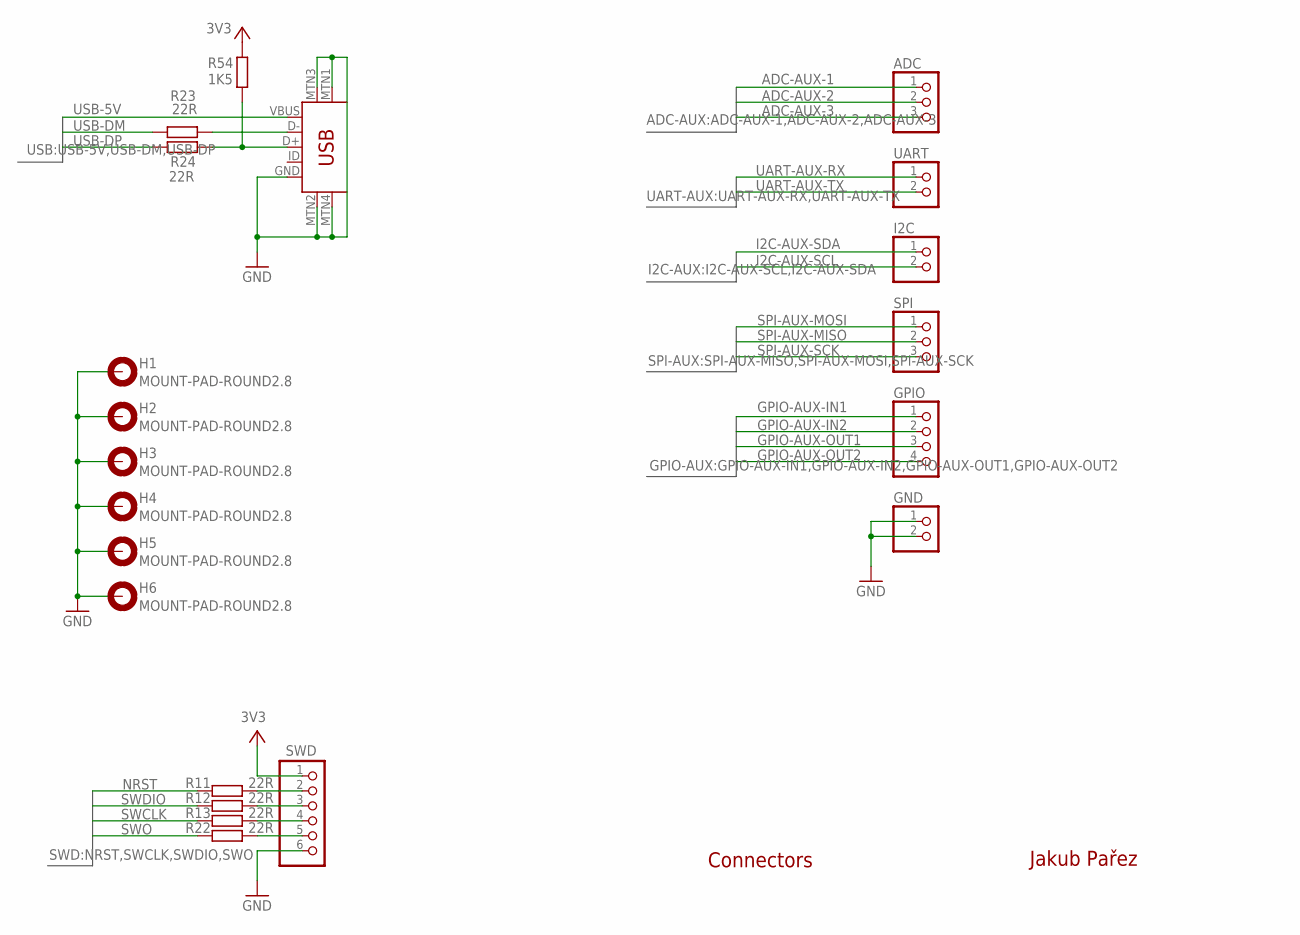
[picture p57: schematic IGBS-Rocket-v2_rev1.sch, sheet 3, Connectors]

Parts:
ADC: PINHD-1X3; 1X03
GND: PINHD-1X2; 1X02
GPIO: PINHD-1X4; 1X04
H1, H2, H3, H4, H5, H6: MOUNT-PAD-ROUND2.8; 2,8-PAD
I2C: PINHD-1X2; 1X02
R11, R12, R13, R22, R23, R24: 22R; R0603
R54: 1K5; R0603
SPI: PINHD-1X3; 1X03
SWD: PINHD-1X6; 1X06
UART: PINHD-1X2; 1X02
USB: USB-MINIB-5PIN; USB-MINIB

Connections:
3V3: R54.2, SWD.1; also elsewhere on the board
ADC-AUX-1: ADC.1; also elsewhere on the board
ADC-AUX-2: ADC.2; also elsewhere on the board
ADC-AUX-3: ADC.3; also elsewhere on the board
GND: GND.1, GND.2, H1.B2,8, H2.B2,8, H3.B2,8, H4.B2,8, H5.B2,8, H6.B2,8, SWD.6, USB.GND, USB.MTN1 (MTN2), USB.MTN2 (MTN3), USB.MTN3 (MTN1), USB.MTN4; also elsewhere on the board
GPIO-AUX-IN1: GPIO.1; also elsewhere on the board
GPIO-AUX-IN2: GPIO.2; also elsewhere on the board
GPIO-AUX-OUT1: GPIO.3; also elsewhere on the board
GPIO-AUX-OUT2: GPIO.4; also elsewhere on the board
I2C-AUX-SCL: I2C.2; also elsewhere on the board
I2C-AUX-SDA: I2C.1; also elsewhere on the board
unnamed: R11.1, SWD.2
unnamed: R12.1, SWD.3
unnamed: R13.1, SWD.4
unnamed: R22.1, SWD.5
unnamed: R23.1, USB.D-
unnamed: R24.1, R54.1, USB.D+
NRST: R11.2; also elsewhere on the board
SPI-AUX-MISO: SPI.2; also elsewhere on the board
SPI-AUX-MOSI: SPI.1; also elsewhere on the board
SPI-AUX-SCK: SPI.3; also elsewhere on the board
SWCLK: R13.2; also elsewhere on the board
SWDIO: R12.2; also elsewhere on the board
SWO: R22.2; also elsewhere on the board
UART-AUX-RX: UART.1; also elsewhere on the board
UART-AUX-TX: UART.2; also elsewhere on the board
USB-5V: USB.VBUS
USB-DM: R23.2; also elsewhere on the board
USB-DP: R24.2; also elsewhere on the board

Notes on the sheet:
Connectors
Jakub Pařez

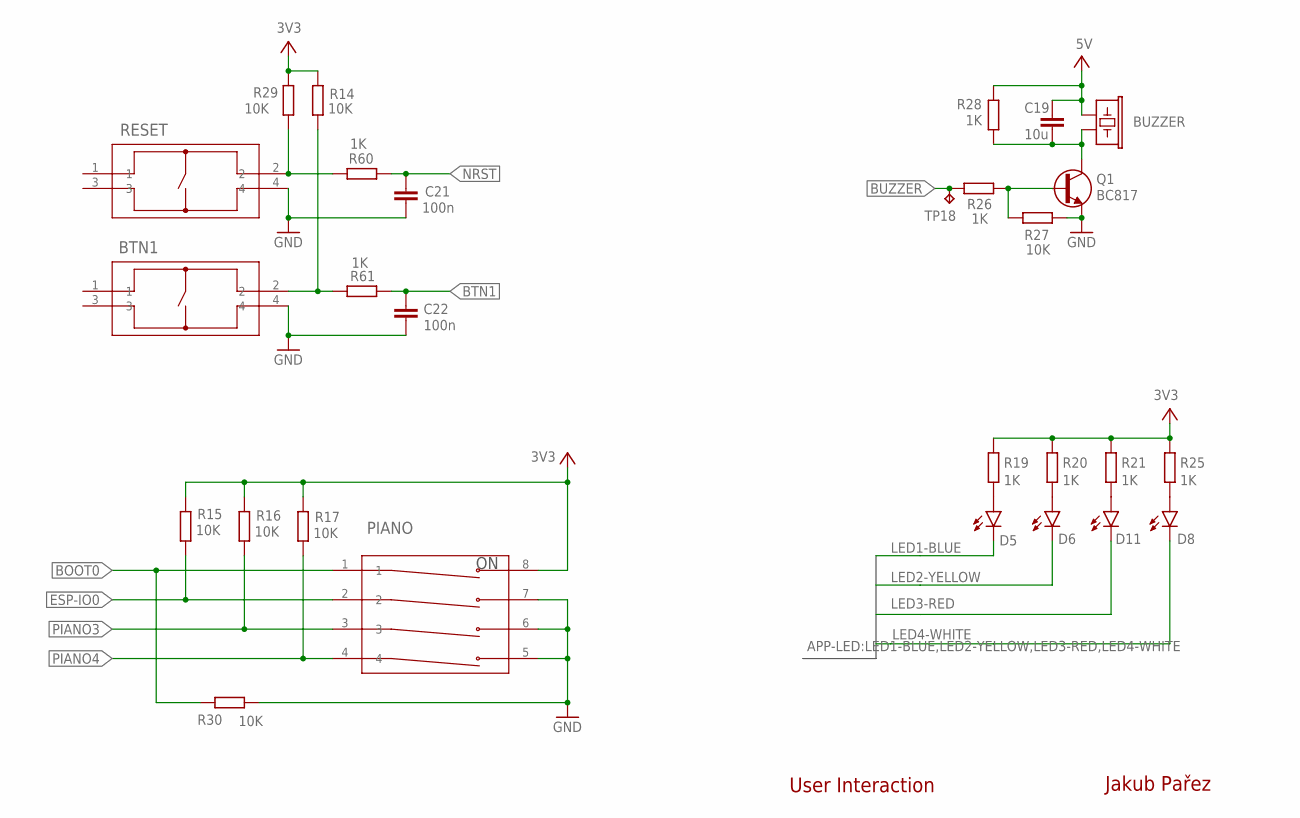
[picture p58: schematic IGBS-Rocket-v2_rev1.sch, sheet 4, User Interaction]

Parts:
BTN1: B3FS-1000SW_B3FS-1000_OMR; SW_B3FS-1000_OMR
BUZZER: BUZZERPTH; BUZZER-12MM
C19: 10u; 0805-CAP
C21, C22: 100n; C0603K
D5, D6, D8, D11: GREEN; LED-1206
PIANO: A6FR-4101SW_A6FR-4101_OMR; SW_A6FR-4101_OMR
Q1: BC817; SOT23-BEC
R14, R15, R16, R17, R27, R29, R30: 10K; R0603
R19, R20, R21, R25, R26, R28, R60, R61: 1K; R0603
RESET: B3FS-1000SW_B3FS-1000_OMR; SW_B3FS-1000_OMR
TP18: TPB1,27; B1,27

Connections:
3V3: PIANO.8, R14.1, R15.2, R16.2, R17.2, R19.2, R20.2, R21.2, R25.2, R29.1; also elsewhere on the board
5V: BUZZER.+ (1), C19.1, R28.1; also elsewhere on the board
5V-BUZZER: BUZZER.- (2), C19.2, Q1.C, R28.2
BOOT0: PIANO.1, R30.1; also elsewhere on the board
BTN1: C22.1, R61.2; also elsewhere on the board
BTN12: BTN1.2, R14.2, R61.1
BUZZER: R26.2, TP18.TP; also elsewhere on the board
ESP-IO0: PIANO.2, R15.1; also elsewhere on the board
GND: BTN1.4, C21.2, C22.2, PIANO.5, PIANO.6, PIANO.7, Q1.E, R27.1, R30.2, RESET.4; also elsewhere on the board
LED1-BLUE: D5.C; also elsewhere on the board
LED2-YELLOW: D6.C; also elsewhere on the board
LED3-RED: D11.C; also elsewhere on the board
LED4-WHITE: D8.C; also elsewhere on the board
unnamed: D8.A, R25.1
unnamed: D5.A, R19.1
unnamed: D6.A, R20.1
unnamed: D11.A, R21.1
unnamed: Q1.B, R26.1, R27.2
NRST: C21.1, R60.2; also elsewhere on the board
NRST2: R29.2, R60.1, RESET.2
PIANO3: PIANO.3, R16.1; also elsewhere on the board
PIANO4: PIANO.4, R17.1; also elsewhere on the board

Notes on the sheet:
User Interaction
Jakub Pařez

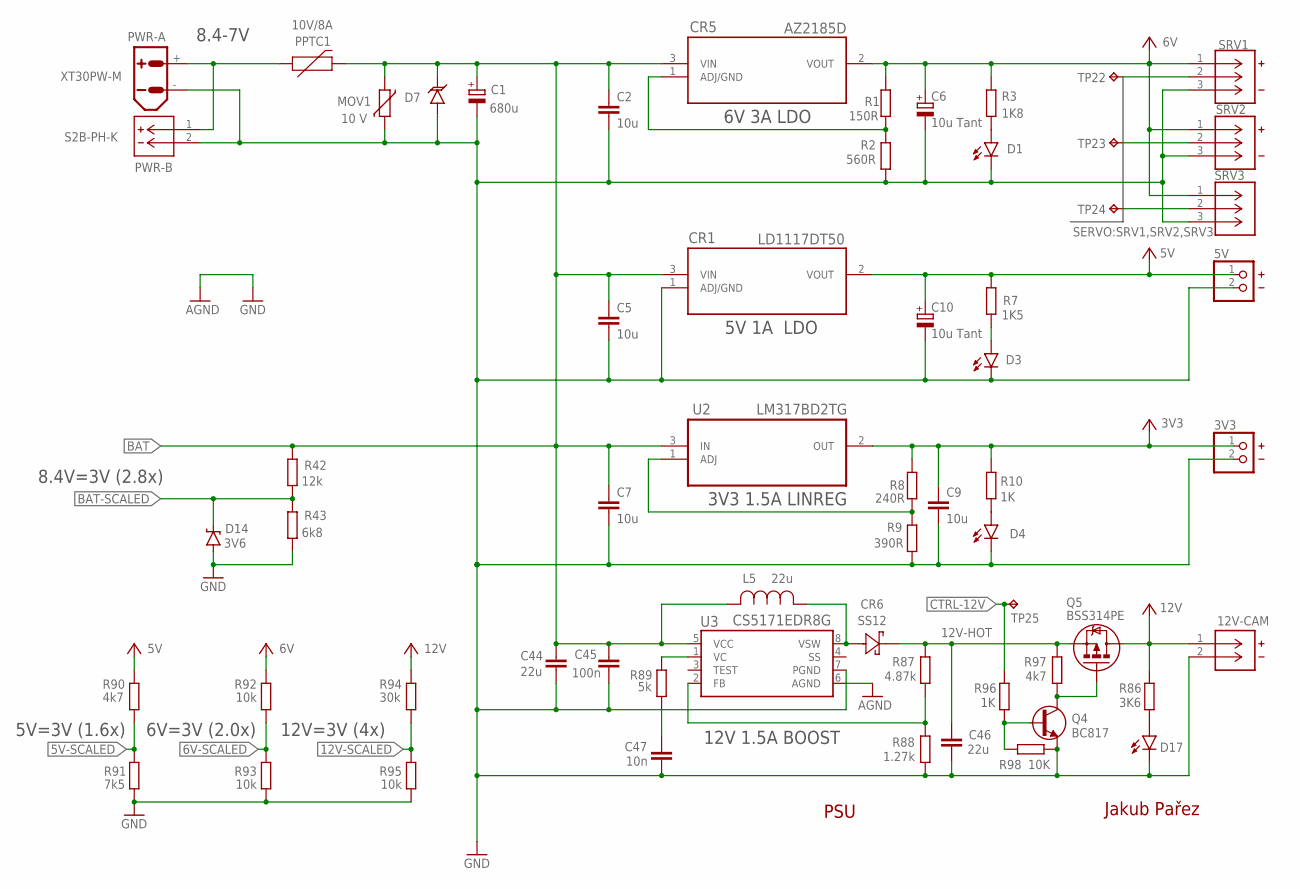
[picture p59: schematic IGBS-Rocket-v2_rev1.sch, sheet 5, PSU]

Parts:
3V3, 5V: PINHD-1X2; 1X02
12V-CAM: S2B-XH-A(LF)(SN)CONN_S2B-XH-A_JST; CONN_S2B-XH-A_JST
C1: 680u; TT2D7L
C2, C5, C7, C9: 10u; 0805-CAP
C6, C10: 10u Tant; CT3216
C44, C46: 22u; 0805-CAP
C45: 100n; C0805K
C47: 10n; C0805K
CR1: LD1117DT50; DPAK229P990X239-3N
CR5: AZ2185D; DPAK229P990X239-3N
CR6: SS12; DIODE_DO214AC
D1, D3, D4, D17: GREEN; LED-1206
D7: TVSSMA; SMA-DIODE
D14: 3V6; SOD-123
L5: 22u; IND_74437_WRE
MOV1: 10 V; CT/CN0805
PPTC1: 10V/8A; 1210
PWR-A: XT30PW-M
PWR-B: S2B-PH-K-S; CONN_S2B-PH-K-S_JST
Q4: BC817; SOT23-BEC
Q5: BSS314PE; SOT23-3
R1: 150R; R0603
R2: 560R; R0603
R3: 1K8; R0603
R7: 1K5; R0603
R8: 240R; R0603
R9: 390R; R0603
R10, R96: 1K; R0603
R42: 12k; R0603
R43: 6k8; R0603
R86: 3K6; R0603
R87: 4.87k; R0603
R88: 1.27k; R0603
R89: 5k; R0603
R90, R97: 4k7; R0603
R91: 7k5; R0603
R92, R93, R95: 10k; R0603
R94: 30k; R0603
R98: 10K; R0603
SRV1: S3B-XH-A; CONN_S3B-XH-A(LF)(SN)_JST
SRV2, SRV3: S3B-XH-A(LF)(SN)CONN_S3B-XH-A(LF)(SN)_JST; CONN_S3B-XH-A(LF)(SN)_JST
TP22, TP23, TP24, TP25: TPB1,27; B1,27
U2: LM317BD2TG; TO263
U3: CS5171EDR8G; SOIC8_ONS

Connections:
3V3: 3V3.1, C9.1, R8.2, R10.2, U2.2 (OUT); also elsewhere on the board
5V: 5V.1, C10.+, CR1.2 (VOUT), R7.2, R90.2; also elsewhere on the board
5V-SCALED: R90.1, R91.2; also elsewhere on the board
6V: C6.+, CR5.2 (VOUT), R1.2, R3.2, R92.2, SRV1.1, SRV2.1, SRV3.1
6V-SCALED: R92.1, R93.2; also elsewhere on the board
12V: 12V-CAM.1, Q5.3 (D), R86.2, R94.2
12V-FB: CR6.2, L5.1, U3.8 (VSW)
12V-HOT: C46.1, CR6.1, Q5.2 (S), R87.2, R97.1
12V-SCALED: R94.1, R95.2; also elsewhere on the board
BAT: C1.+, C2.1, C5.1, C7.1, C44.1, C45.2, CR1.3 (VIN), CR5.3 (VIN), D7.C, L5.2, MOV1.1, PPTC1.2, R42.2, U2.3 (IN), U3.5 (VCC); also elsewhere on the board
BAT2: PPTC1.1, PWR-A.+, PWR-B.1
BAT-SCALED: D14.C, R42.1, R43.2; also elsewhere on the board
CTRL-12V: R96.2, TP25.TP; also elsewhere on the board
GND: 3V3.2, 5V.2, 12V-CAM.2, C1.-, C2.2, C5.2, C6.-, C7.2, C9.2, C10.-, C44.2, C45.1, C46.2, C47.1, CR1.1 (ADJ/GND), D1.C, D3.C, D4.C, D7.A, D14.A, D17.C, MOV1.2, PWR-A.-, PWR-B.2, Q4.E, R2.1, R9.1, R43.1, R88.1, R91.1, R93.1, R95.1, R98.1, SRV1.3, SRV2.3, SRV3.3, U3.6 (AGND), U3.7 (PGND); also elsewhere on the board
unnamed: CR5.1 (ADJ/GND), R1.1, R2.2
unnamed: D1.A, R3.1
unnamed: D3.A, R7.1
unnamed: R8.1, R9.2, U2.1 (ADJ)
unnamed: D4.A, R10.1
unnamed: R87.1, R88.2, U3.2 (FB)
unnamed: D17.A, R86.1
unnamed: Q4.B, R96.1, R98.2
unnamed: C47.2, R89.1
unnamed: R89.2, U3.1 (VC)
unnamed: Q4.C, Q5.1 (G), R97.2
SRV1: SRV1.2, TP22.TP; also elsewhere on the board
SRV2: SRV2.2, TP23.TP; also elsewhere on the board
SRV3: SRV3.2, TP24.TP; also elsewhere on the board

Notes on the sheet:
PSU
Jakub Pařez
3V3 1.5A LINREG
6V 3A LDO
5V 1A LDO
8.4-7V
S2B-PH-K
8.4V=3V (2.8x)
12V 1.5A BOOST
5V=3V (1.6x)
6V=3V (2.0x)
12V=3V (4x)

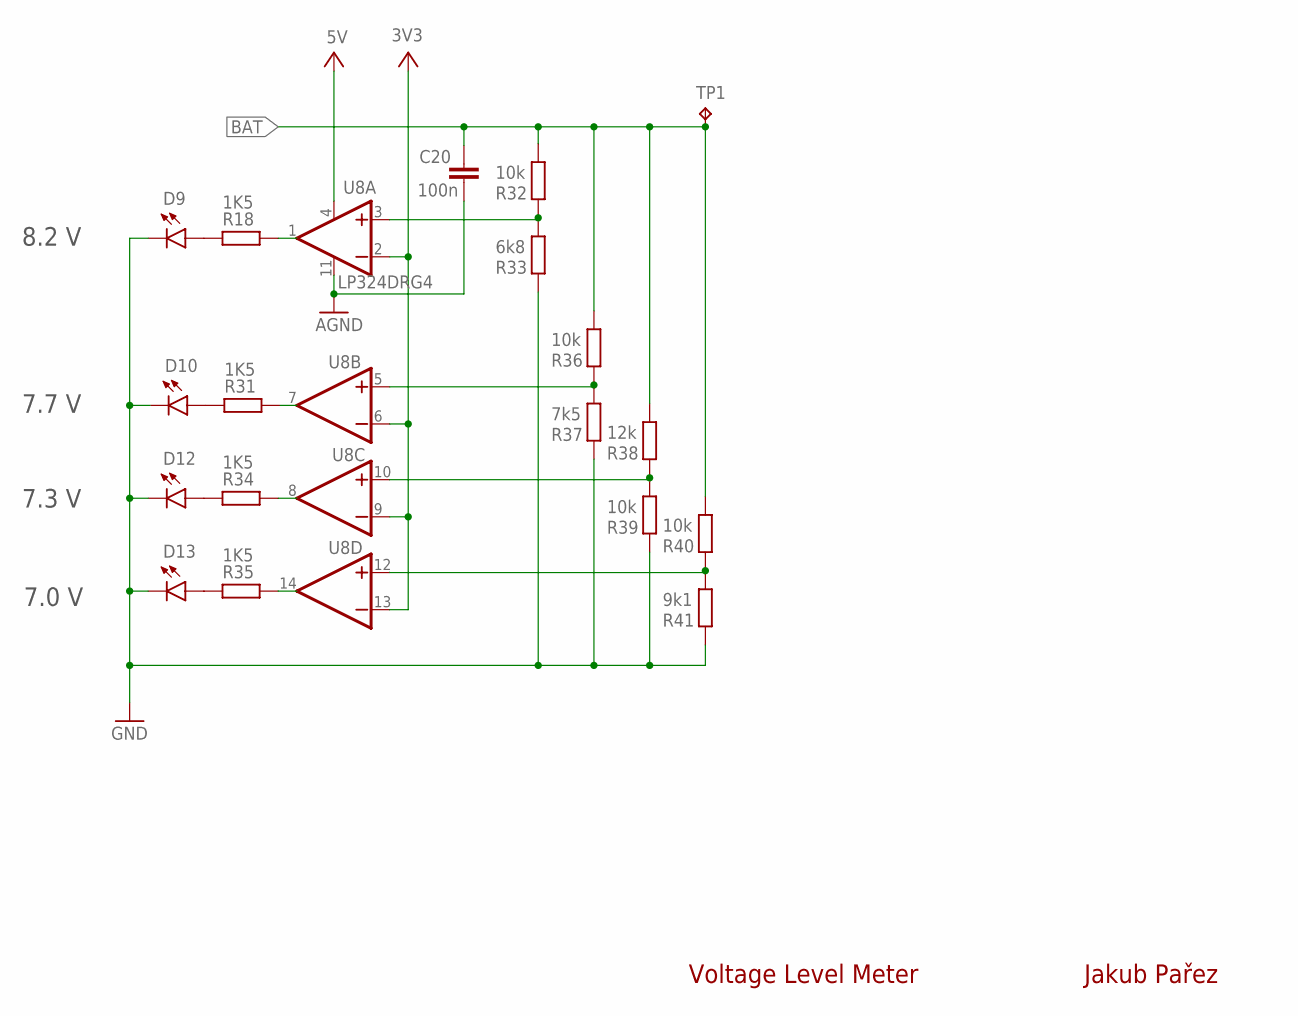
[picture p60: schematic IGBS-Rocket-v2_rev1.sch, sheet 6, Voltage Meter]

Parts:
C20: 100n; C0603K
D9, D10, D12, D13: GREEN; LED-1206
R18, R31, R34, R35: 1K5; R0603
R32, R36, R39, R40: 10k; R0603
R33: 6k8; R0603
R37: 7k5; R0603
R38: 12k; R0603
R41: 9k1; R0603
TP1: TPB2,54; B2,54
U8: LP324DRG4; D14

Connections:
3V3: U8.2 (-), U8.6 (-), U8.9 (-), U8.13 (-); also elsewhere on the board
5V: U8.4 (VCC); also elsewhere on the board
BAT: C20.2, R32.2, R36.2, R38.2, R40.2, TP1.TP; also elsewhere on the board
GND: C20.1, D9.C, D10.C, D12.C, D13.C, R33.1, R37.1, R39.1, R41.1, U8.11 (GND); also elsewhere on the board
unnamed: D9.A, R18.1
unnamed: D10.A, R31.1
unnamed: D12.A, R34.1
unnamed: D13.A, R35.1
unnamed: R35.2, U8.14 (OUT)
unnamed: R34.2, U8.8 (OUT)
unnamed: R31.2, U8.7 (OUT)
unnamed: R18.2, U8.1 (OUT)
unnamed: R32.1, R33.2, U8.3 (+)
unnamed: R36.1, R37.2, U8.5 (+)
unnamed: R38.1, R39.2, U8.10 (+)
unnamed: R40.1, R41.2, U8.12 (+)

Notes on the sheet:
Voltage Level Meter
8.2 V
7.7 V
7.3 V
7.0 V
Jakub Pařez

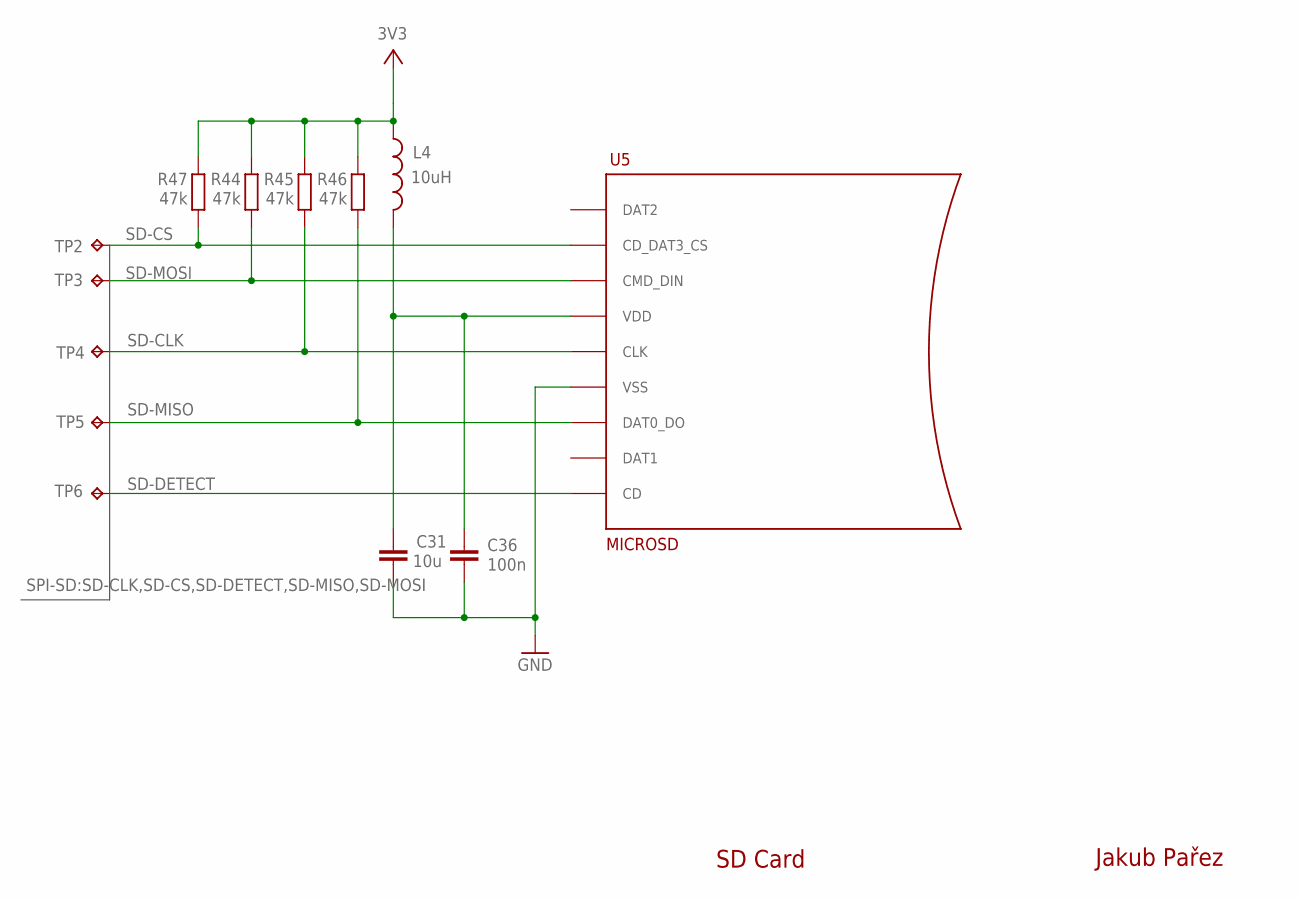
[picture p61: schematic IGBS-Rocket-v2_rev1.sch, sheet 7, SD Card]

Parts:
C31: 10u; 0805-CAP
C36: 100n; C0603K
L4: 10uH; 0805
R44, R45, R46, R47: 47k; R0603
TP2, TP3, TP4, TP5, TP6: TPB1,27; B1,27
U5: MICROSD; MICROSD-PUSH-OUT

Connections:
3V3: L4.1, R44.2, R45.2, R46.2, R47.2; also elsewhere on the board
3V3-SD: C31.1, C36.1, L4.2, U5.4 (VDD)
GND: C31.2, C36.2, U5.6 (VSS), U5.G1 (VSS), U5.G2 (VSS), U5.G3 (VSS), U5.G4 (VSS); also elsewhere on the board
SD-CLK: R45.1, TP4.TP, U5.5 (CLK); also elsewhere on the board
SD-CS: R47.1, TP2.TP, U5.2 (CD_DAT3_CS); also elsewhere on the board
SD-DETECT: TP6.TP, U5.CD; also elsewhere on the board
SD-MISO: R46.1, TP5.TP, U5.7 (DAT0_DO); also elsewhere on the board
SD-MOSI: R44.1, TP3.TP, U5.3 (CMD_DIN); also elsewhere on the board

Notes on the sheet:
SD Card
Jakub Pařez

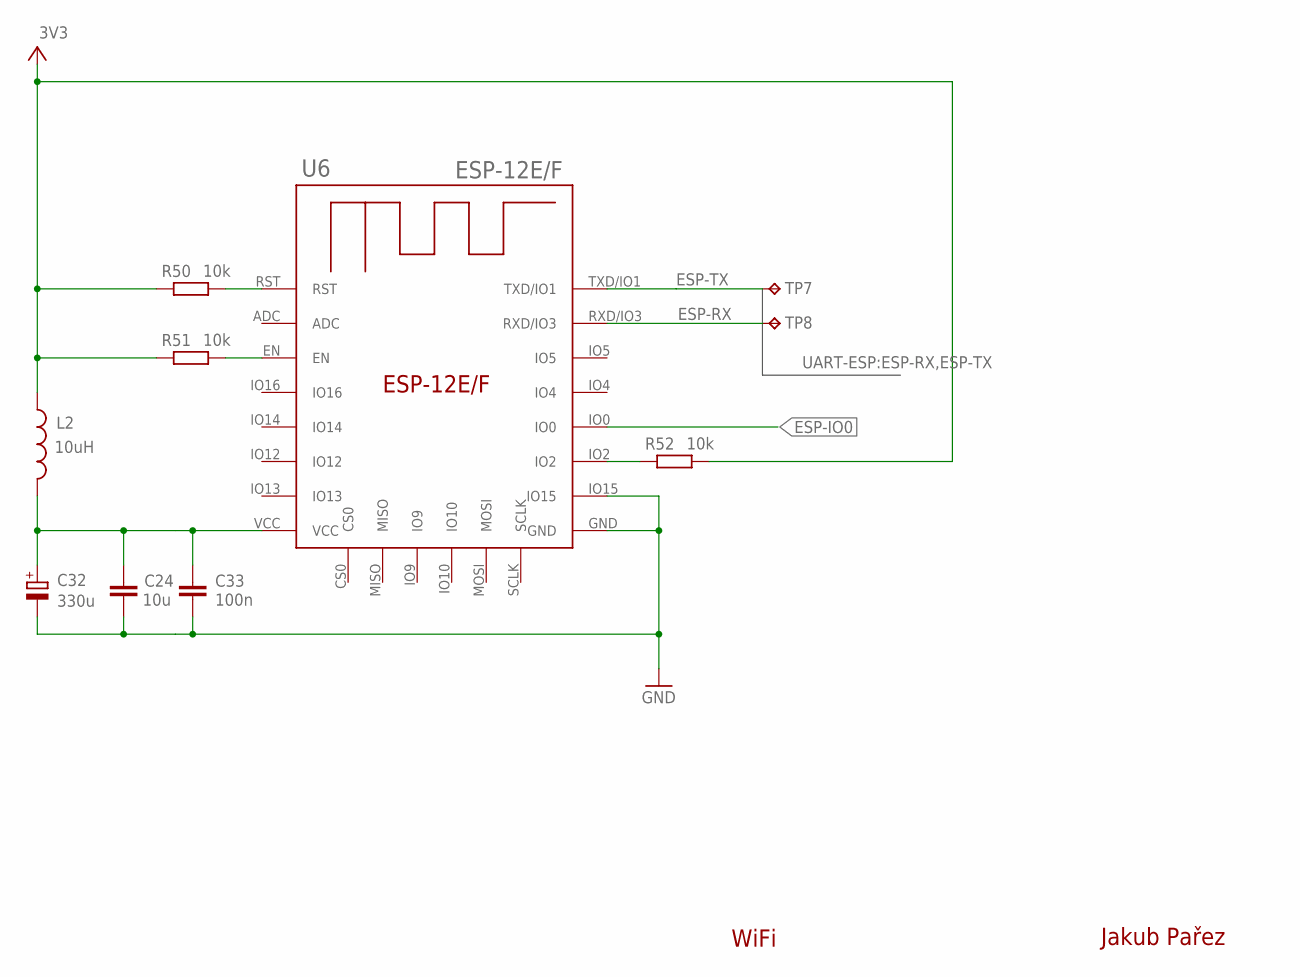
[picture p62: schematic IGBS-Rocket-v2_rev1.sch, sheet 8, WiFi]

Parts:
C24: 10u; 0805-CAP
C32: 330u; E2,5-7
C33: 100n; C0603K
L2: 10uH; 0805
R50, R51, R52: 10k; R0603
TP7, TP8: TPB1,27; B1,27
U6: ESP-12E/F; ESP-12E

Connections:
3V3: L2.1, R50.2, R51.2, R52.1; also elsewhere on the board
3V3-ESP: C24.1, C32.+, C33.1, L2.2, U6.VCC
ESP-IO0: U6.IO0; also elsewhere on the board
ESP-RX: TP8.TP, U6.RXD/IO3; also elsewhere on the board
ESP-TX: TP7.TP, U6.TXD/IO1; also elsewhere on the board
GND: C24.2, C32.-, C33.2, U6.GND, U6.IO15; also elsewhere on the board
unnamed: R50.1, U6.RST
unnamed: R51.1, U6.EN
unnamed: R52.2, U6.IO2

Notes on the sheet:
WiFi
Jakub Pařez

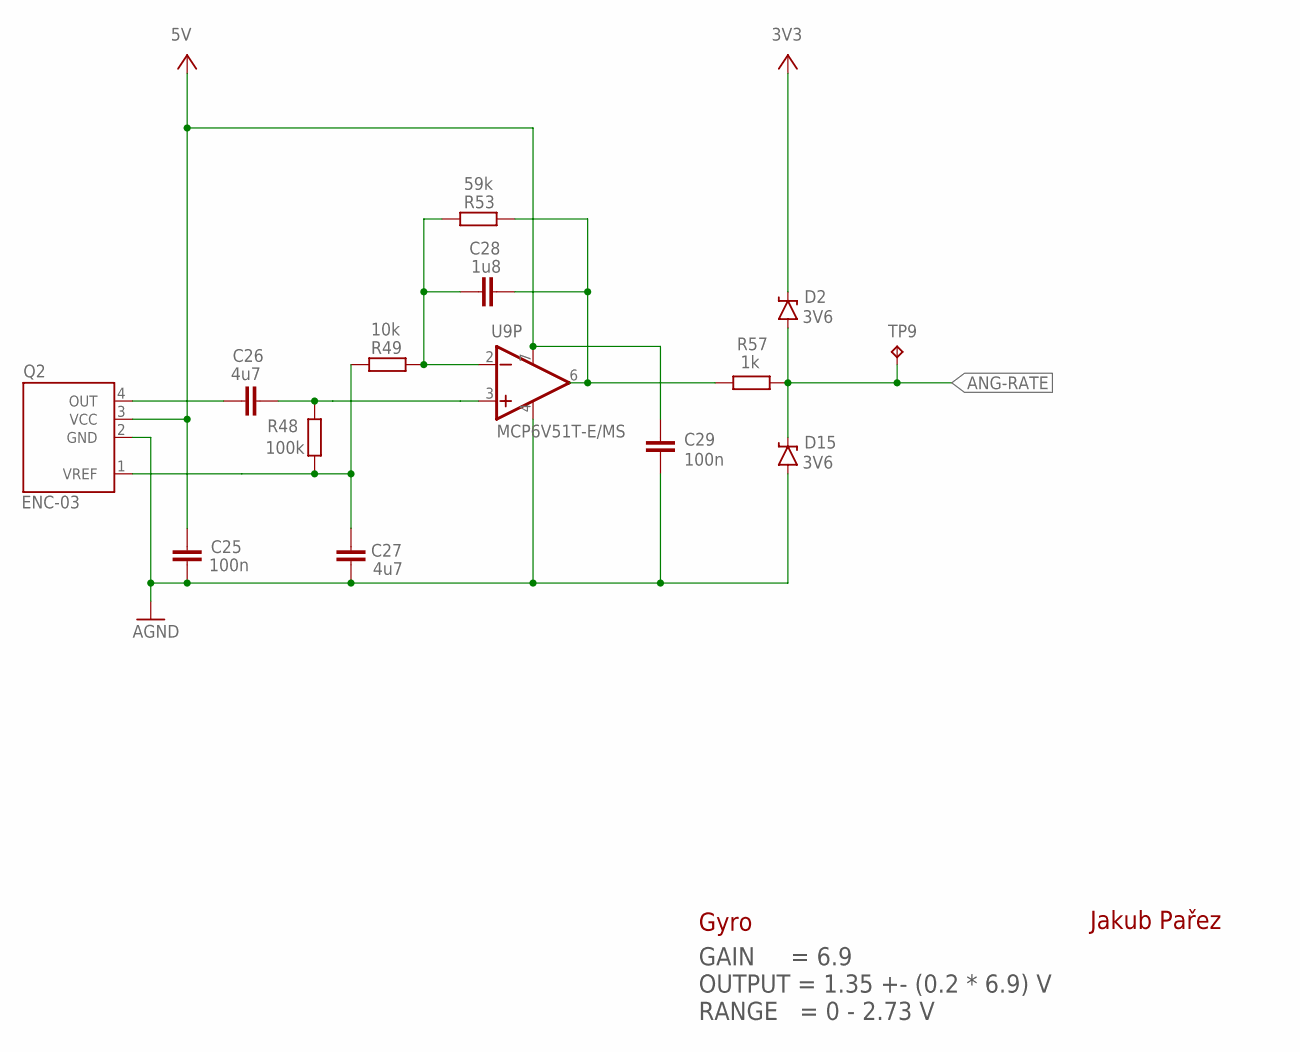
[picture p63: schematic IGBS-Rocket-v2_rev1.sch, sheet 9, Gyro]

Parts:
C25, C29: 100n; C0603K
C26, C27: 4u7; C0805K
C28: 1u8; C0805K
D2, D15: 3V6; SOD-123
Q2: ENC-03; ENC-03RC
R48: 100k; R0603
R49: 10k; R0603
R53: 59k; R0603
R57: 1k; R0603
TP9: TPB1,27; B1,27
U9: MCP6V51T-E/MS; MSOP8_MS_MCH

Connections:
3V3: D2.C; also elsewhere on the board
5V: C25.2, C29.2, Q2.3 (VCC), U9.7 (VCC); also elsewhere on the board
ANG-RATE: D2.A, D15.C, R57.1, TP9.TP; also elsewhere on the board
ANG-RATE2: C28.2, R53.1, R57.2, U9.6 (OUT)
GND: C25.1, C27.2, C29.1, D15.A, Q2.2 (GND), U9.4 (GND); also elsewhere on the board
unnamed: C26.2, Q2.4 (OUT)
unnamed: C26.1, R48.2, U9.3 (+)
unnamed: C27.1, Q2.1 (VREF), R48.1, R49.1
unnamed: C28.1, R49.2, R53.2, U9.2 (-)

Notes on the sheet:
Gyro
Jakub Pařez
GAIN = 6.9 OUTPUT = 1.35 +- (0.2 * 6.9) V RANGE = 0 - 2.73 V

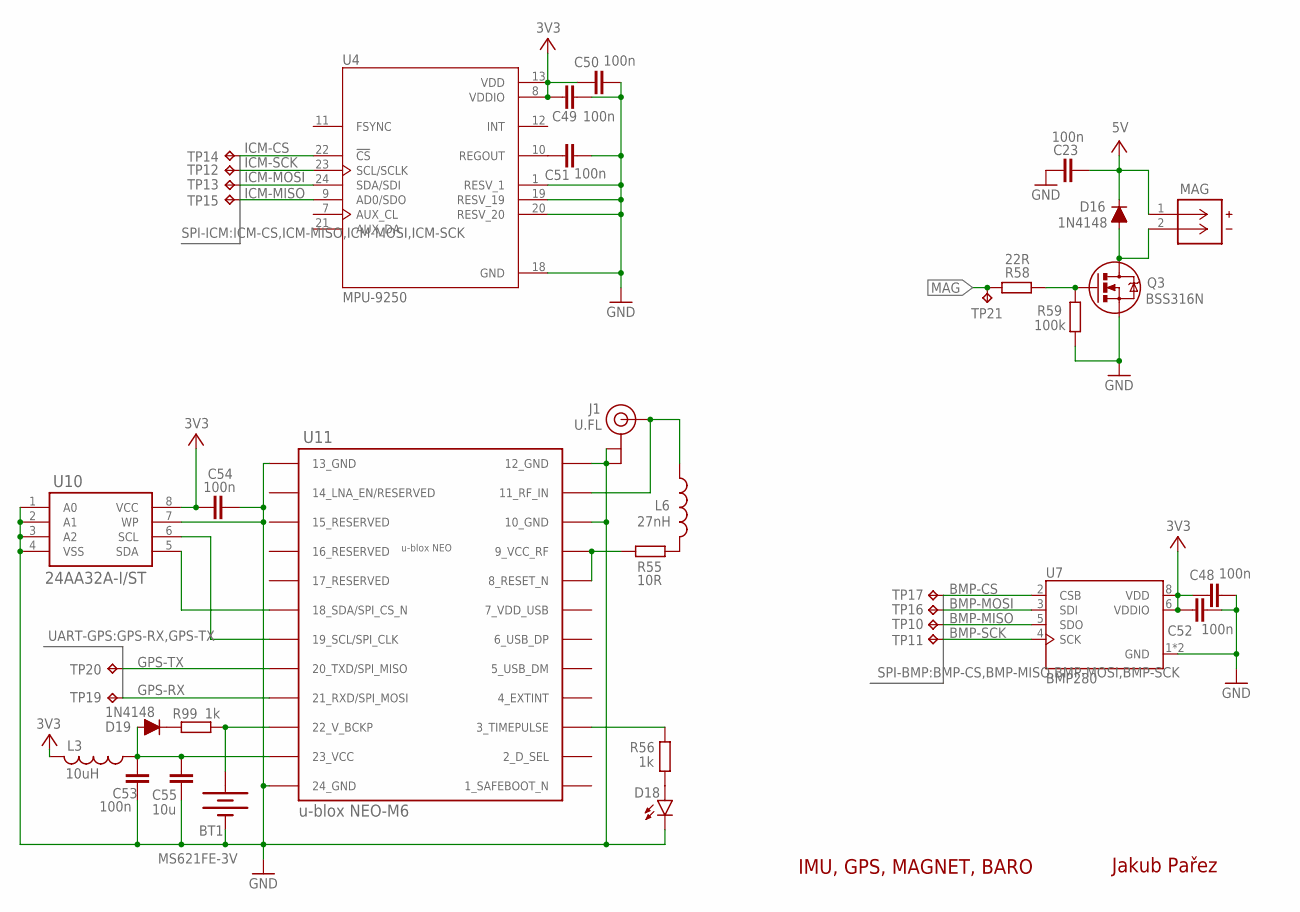
[picture p64: schematic IGBS-Rocket-v2_rev1.sch, sheet 10, Modules]

Parts:
BT1: MS621FE-3V; BATTCON-6.8MM
C23, C48, C49, C50, C51, C52, C53, C54: 100n; C0603K
C55: 10u; 0805-CAP
D16, D19: 1N4148; SOD-123
D18: GREEN; LED-1206
J1: U.FL
L3: 10uH; 0805
L6: 27nH; C0402
MAG: S2B-XH-A(LF)(SN)CONN_S2B-XH-A_JST; CONN_S2B-XH-A_JST
Q3: BSS316N; SOT23-3
R55: 10R; R0603
R56, R99: 1k; R0603
R58: 22R; R0603
R59: 100k; R0603
TP10, TP11, TP12, TP13, TP14, TP15, TP16, TP17, TP19, TP20, TP21: TPB1,27; B1,27
U4: MPU-9250; QFN40P300X300X105-24N
U7: BMP280; XDCR_BMP280
U10: 24AA32A-I/ST; TSSOP8_MC_MCH
U11: u-blox NEO-M6; NEO-M8

Connections:
3V3: C48.2, C49.2, C50.2, C52.2, C54.1, L3.2, U4.8 (VDDIO), U4.13 (VDD), U7.6 (VDDIO), U7.8 (VDD), U10.8 (VCC); also elsewhere on the board
5V: C23.1, D16.C, MAG.1; also elsewhere on the board
5V-MAG: D16.A, MAG.2, Q3.3 (D)
BMP-CS: TP17.TP, U7.2 (CSB); also elsewhere on the board
BMP-MISO: TP10.TP, U7.5 (SDO); also elsewhere on the board
BMP-MOSI: TP16.TP, U7.3 (SDI); also elsewhere on the board
BMP-SCK: TP11.TP, U7.4 (SCK); also elsewhere on the board
GND: BT1.-, C23.2, C48.1, C49.1, C50.1, C51.1, C52.1, C53.2, C54.2, C55.2, D18.C, J1.P$1 (GND), J1.P$2 (GND), Q3.2 (S), R59.1, U4.1 (RESV_1), U4.18 (GND), U4.19 (RESV_19), U4.20 (RESV_20), U7.1 (GND), U7.7 (GND), U10.1 (A0), U10.2 (A1), U10.3 (A2), U10.4 (VSS), U10.7 (WP), U11.10 (10_GND), U11.12 (12_GND), U11.13 (13_GND), U11.24 (24_GND); also elsewhere on the board
GPS-RF-IN: J1.P$3 (SIGNAL), L6.1, U11.11 (11_RF_IN)
GPS-RX: TP19.TP, U11.21 (21_RXD/SPI_MOSI); also elsewhere on the board
GPS-TX: TP20.TP, U11.20 (20_TXD/SPI_MISO); also elsewhere on the board
GPS-VBCKP: BT1.+, R99.2, U11.22 (22_V_BCKP)
GPS-VBCKP2: D19.C, R99.1
GPS-VCC: C53.1, C55.1, D19.A, L3.1, U11.23 (23_VCC)
GPS-VCC-RF: R55.2, U11.8 (8_RESET_N), U11.9 (9_VCC_RF)
ICM-CS: TP14.TP, U4.22 (!CS); also elsewhere on the board
ICM-MISO: TP15.TP, U4.9 (AD0/SDO); also elsewhere on the board
ICM-MOSI: TP13.TP, U4.24 (SDA/SDI); also elsewhere on the board
ICM-SCK: TP12.TP, U4.23 (SCL/SCLK); also elsewhere on the board
MAG: R58.1, TP21.TP; also elsewhere on the board
unnamed: Q3.1 (G), R58.2, R59.2
unnamed: U10.6 (SCL), U11.19 (19_SCL/SPI_CLK)
unnamed: U10.5 (SDA), U11.18 (18_SDA/SPI_CS_N)
unnamed: C51.2, U4.10 (REGOUT)
unnamed: D18.A, R56.1
unnamed: L6.2, R55.1
unnamed: R56.2, U11.3 (3_TIMEPULSE)

Notes on the sheet:
IMU, GPS, MAGNET, BARO
Jakub Pařez
