ItsGoodButStill/IGBS-Rocket-v2/pcb/IGBS-Rocket-v2_PCB_rev1/IGBS-Rocket-v2_rev1.brd

## EAGLE design pcb/IGBS-Rocket-v2_PCB_rev1/IGBS-Rocket-v2_rev1.brd (continued)

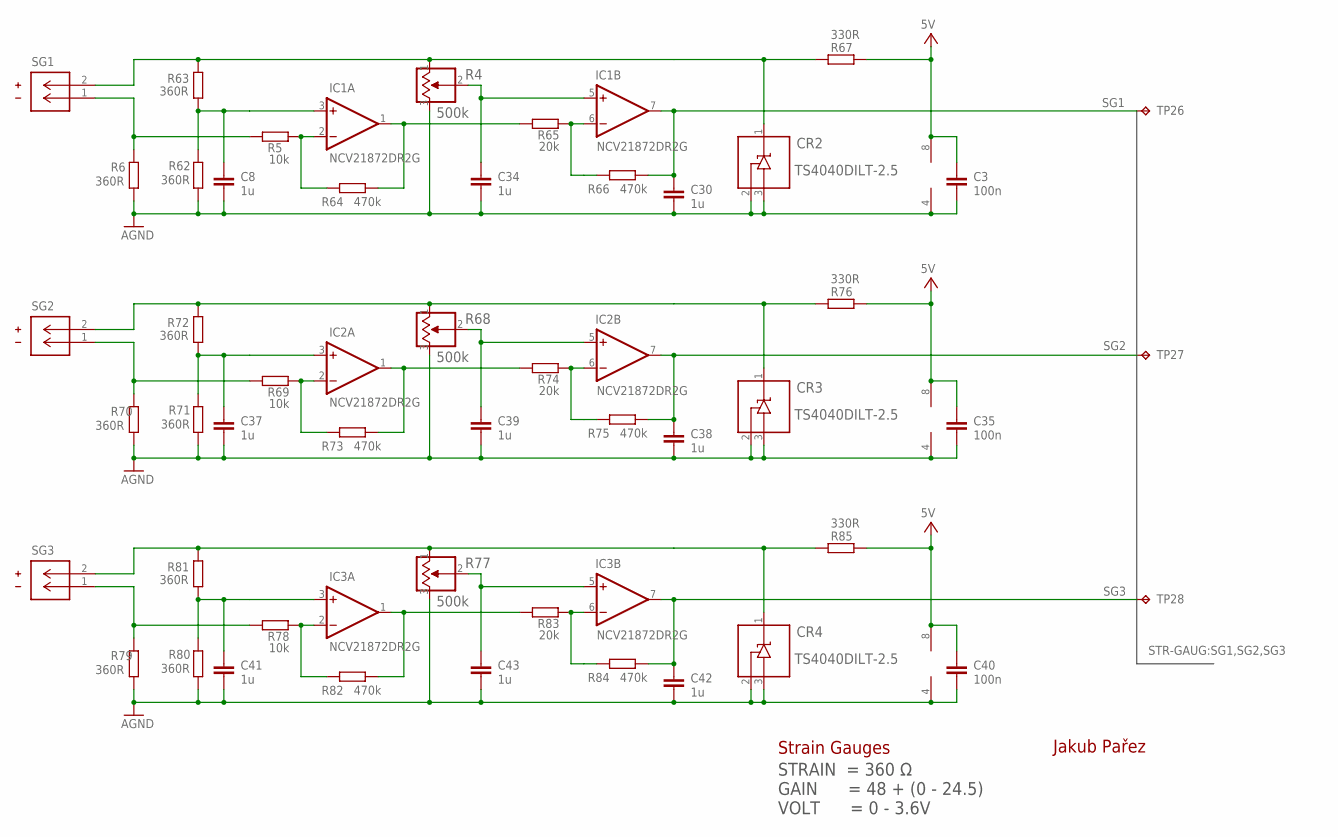
[picture p65: schematic IGBS-Rocket-v2_rev1.sch, sheet 11, Strain Gauges]

Parts:
C3, C35, C40: 100n; C0603K
C8, C30, C34, C37, C38, C39, C41, C42, C43: 1u; C0603K
CR2, CR3, CR4: TS4040DILT-2.5; SOT23_TO-236AB_NEX
IC1, IC2, IC3: NCV21872DR2G; SO08
R4, R68, R77: 500k; RES_C01R00
R5, R69, R78: 10k; R0603
R6, R62, R63, R70, R71, R72, R79, R80, R81: 360R; R0603
R64, R66, R73, R75, R82, R84: 470k; R0603
R65, R74, R83: 20k; R0603
R67, R76, R85: 330R; R0603
SG1, SG2, SG3: S3B-XH-A; CONN_S2B-XH-A_JST
TP26, TP27, TP28: TPB1,27; B1,27

Connections:
5V: C3.2, C35.2, C40.2, IC1.8 (V+), IC2.8 (V+), IC3.8 (V+), R67.2, R76.2, R85.2; also elsewhere on the board
GND: C3.1, C8.1, C30.1, C34.1, C35.1, C37.1, C38.1, C39.1, C40.1, C41.1, C42.1, C43.1, CR2.2, CR2.3, CR3.2, CR3.3, CR4.2, CR4.3, IC1.4 (V-), IC2.4 (V-), IC3.4 (V-), R4.3, R6.2, R62.2, R68.3, R70.2, R71.2, R77.3, R79.2, R80.2; also elsewhere on the board
unnamed: R69.2, R70.1, SG2.1
unnamed: R5.2, R6.1, SG1.1
unnamed: C8.2, IC1.3 (+IN), R62.1, R63.2
unnamed: C37.2, IC2.3 (+IN), R71.1, R72.2
unnamed: IC1.2 (-IN), R5.1, R64.2
unnamed: IC1.1 (OUT), R64.1, R65.2
unnamed: IC1.6 (-IN), R65.1, R66.2
unnamed: C34.2, IC1.5 (+IN), R4.2
unnamed: CR2.1, R4.1, R63.1, R67.1, SG1.2
unnamed: IC2.2 (-IN), R69.1, R73.2
unnamed: IC2.1 (OUT), R73.1, R74.2
unnamed: IC2.6 (-IN), R74.1, R75.2
unnamed: C39.2, IC2.5 (+IN), R68.2
unnamed: CR3.1, R68.1, R72.1, R76.1, SG2.2
unnamed: R78.2, R79.1, SG3.1
unnamed: C41.2, IC3.3 (+IN), R80.1, R81.2
unnamed: IC3.2 (-IN), R78.1, R82.2
unnamed: IC3.1 (OUT), R82.1, R83.2
unnamed: IC3.6 (-IN), R83.1, R84.2
unnamed: C43.2, IC3.5 (+IN), R77.2
unnamed: CR4.1, R77.1, R81.1, R85.1, SG3.2
SG1: C30.2, IC1.7 (OUT), R66.1, TP26.TP; also elsewhere on the board
SG2: C38.2, IC2.7 (OUT), R75.1, TP27.TP; also elsewhere on the board
SG3: C42.2, IC3.7 (OUT), R84.1, TP28.TP; also elsewhere on the board

Notes on the sheet:
Strain Gauges
Jakub Pařez
STRAIN = 360 Ω GAIN = 48 + (0 - 24.5) VOLT = 0 - 3.6V

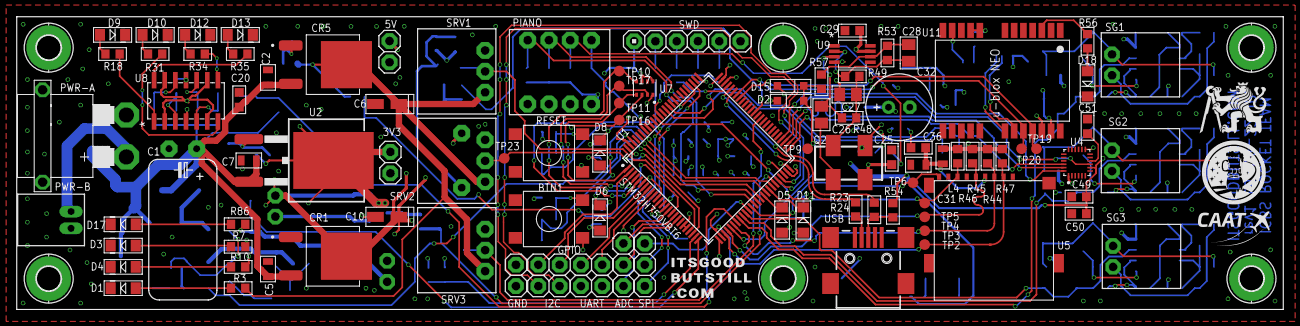
[picture p66: board IGBS-Rocket-v2_rev1.brd from above]

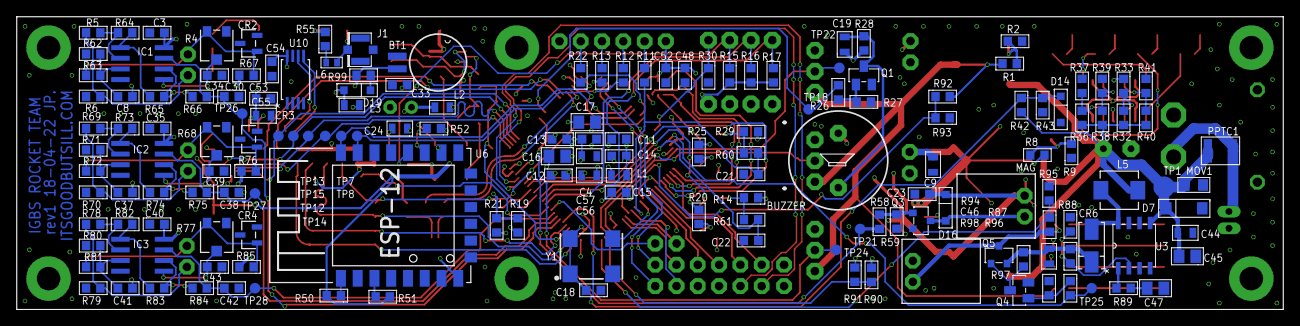
[picture p67: board IGBS-Rocket-v2_rev1.brd from below]

Board: 4 copper layers, 151.1 x 34.9 mm, 269 parts (164 on the bottom side), 154 nets.
