ItsGoodButStill/IGBS-Rocket-v2/fw/board/rev1/IGBS-Rocket-v2_rev1.ioc

Mcu.UserName=STM32H750VBTx
PA0.GPIO_Label=TIM2 CH1 PWM - SERVO1
PA0.Signal=S_TIM2_CH1
PA1.GPIO_Label=TIM5 CH2 PWM - SERVO2
PA1.Signal=S_TIM5_CH2
PA10.GPIO_Label=USART1 RX - GPS
PA10.Signal=USART1_RX
PA11.Signal=USB_OTG_FS_DM
PA12.Signal=USB_OTG_FS_DP
PA2.GPIO_Label=ADC2 IN14 - 5V
PA2.Signal=ADCx_INP14
PA3.GPIO_Label=ADC2 IN15 - 12V
PA3.Signal=ADCx_INP15
PA4.GPIO_Label=SPI1 NSS - SDCARD
PA4.Signal=SPI1_NSS
PA5.GPIO_Label=SPI1 SCK - SDCARD
PA5.Signal=SPI1_SCK
PA6.GPIO_Label=ADC1 IN3 - ANG-RATE
PA6.Signal=ADCx_INP3
PA7.GPIO_Label=SPI1 MOSI - SDCARD
PA7.Signal=SPI1_MOSI
PA9.GPIO_Label=USART1 TX - GPS
PA9.Signal=USART1_TX
PB0.GPIO_Label=ADC2 IN9 - GAUG2
PB0.Signal=ADCx_INP9
PB1.GPIO_Label=ADC2 IN5 - GAUG3
PB1.Signal=ADCx_INP5
PB10.GPIO_Label=I2C2 SCL - AUX
PB10.Signal=I2C2_SCL
PB11.GPIO_Label=I2C2 SDA - AUX
PB11.Signal=I2C2_SDA
PB12.GPIO_Label=SPI2 NSS - IMU
PB12.Signal=SPI2_NSS
PB13.GPIO_Label=SPI2 SCK - IMU
PB13.Signal=SPI2_SCK
PB14.GPIO_Label=SPI2 MISO - IMU
PB14.Signal=SPI2_MISO
PB15.GPIO_Label=SPI2 MOSI - IMU
PB15.Signal=SPI2_MOSI
PB2.GPIO_Label=SPI3 MOSI - AUX
PB2.Signal=SPI3_MOSI
PB6.GPIO_Label=I2C1 SCL - INTERN
PB6.Signal=I2C1_SCL
PB7.GPIO_Label=I2C1 SDA - INTERN
PB7.Signal=I2C1_SDA
PC0.GPIO_Label=ADC3 IN10 - AUX 3
PC0.Signal=ADCx_INP10
PC1.GPIO_Label=ADC2 IN11 - 6V
PC1.Signal=ADCx_INP11
PC10.GPIO_Label=SPI3 SCK - AUX
PC10.Signal=SPI3_SCK
PC11.GPIO_Label=SPI3 MISO - AUX
PC11.Signal=SPI3_MISO
PC13.GPIO_Label=GPIO AUX - IN2
PC13.Signal=GPIO_Input
PC2_C.GPIO_Label=ADC3 IN0 - AUX 1
PC2_C.Signal=ADC3_INP0
PC3_C.GPIO_Label=ADC3 IN1 - AUX 2
PC3_C.Signal=ADC3_INP1
PC4.GPIO_Label=ADC2 IN4 - BAT
PC4.Signal=ADCx_INP4
PC5.GPIO_Label=ADC2 IN8 - GAUG1
PC5.Signal=ADCx_INP8
PC6.GPIO_Label=TIM3 CH1 PWM - BUZZER
PC6.Signal=S_TIM3_CH1
PD14.GPIO_Label=TIM4 CH3 PWM - SERVO3
PD14.Signal=S_TIM4_CH3
PD5.GPIO_Label=USART2 TX - WIFI
PD5.Signal=USART2_TX
PD6.GPIO_Label=USART2 RX - WIFI
PD6.Signal=USART2_RX
PD8.GPIO_Label=USART3 TX - AUX
PD8.Signal=USART3_TX
PD9.GPIO_Label=USART3 RX - AUX
PD9.Signal=USART3_RX
PE1.GPIO_Label=GPIO OUT - CTRL 12V
PE1.Signal=GPIO_Output
PE10.GPIO_Label=GPIO IN - BTN1
PE10.Signal=GPIO_Input
PE11.GPIO_Label=GPIO OUT - LED 1 (RED)
PE11.Signal=GPIO_Output
PE12.GPIO_Label=GPIO OUT - LED 2 (GREEN)
PE12.Signal=GPIO_Output
PE13.GPIO_Label=GPIO OUT - LED 3 (BLUE)
PE13.Signal=GPIO_Output
PE14.GPIO_Label=GPIO OUT - LED 4 (ORANGE)
PE14.Signal=GPIO_Output
PE15.GPIO_Label=GPIO OUT - MAGNET
PE15.Signal=GPIO_Output
PE2.GPIO_Label=SPI4 SCK - BMP
PE2.Signal=SPI4_SCK
PE3.GPIO_Label=GPIO AUX - IN1
PE3.Signal=GPIO_Input
PE4.GPIO_Label=SPI4 CS - BMP
PE4.Signal=SPI4_NSS
PE5.GPIO_Label=SPI4 MISO - BMP
PE5.Signal=SPI4_MISO
PE6.GPIO_Label=SPI4 MOSI - BMP
PE6.Signal=SPI4_MOSI
PE7.GPIO_Label=GPIO IN - SDCARD DETECT
PE7.Signal=GPIO_Input
PE8.GPIO_Label=GPIO IN - PIANO3
PE8.Signal=GPIO_Input
PE9.GPIO_Label=GPIO IN - PIANO4
PE9.Signal=GPIO_Input
