ItsGoodButStill/IGBS-Rocket-v2/fw/src/cfg/SEGGER_SYSVIEW_Config_FreeRTOS.c

/*********************************************************************
*                    SEGGER Microcontroller GmbH                     *
*                        The Embedded Experts                        *
**********************************************************************
*                                                                    *
*            (c) 1995 - 2021 SEGGER Microcontroller GmbH             *
*                                                                    *
*       www.segger.com     Support: support@segger.com               *
*                                                                    *
**********************************************************************
*                                                                    *
*       SEGGER SystemView * Real-time application analysis           *
*                                                                    *
**********************************************************************
*                                                                    *
* All rights reserved.                                               *
*                                                                    *
* SEGGER strongly recommends to not make any changes                 *
* to or modify the source code of this software in order to stay     *
* compatible with the SystemView and RTT protocol, and J-Link.       *
*                                                                    *
* Redistribution and use in source and binary forms, with or         *
* without modification, are permitted provided that the following    *
* condition is met:                                                  *
*                                                                    *
* o Redistributions of source code must retain the above copyright   *
*   notice, this condition and the following disclaimer.             *
*                                                                    *
* THIS SOFTWARE IS PROVIDED BY THE COPYRIGHT HOLDERS AND             *
* CONTRIBUTORS "AS IS" AND ANY EXPRESS OR IMPLIED WARRANTIES,        *
* INCLUDING, BUT NOT LIMITED TO, THE IMPLIED WARRANTIES OF           *
* MERCHANTABILITY AND FITNESS FOR A PARTICULAR PURPOSE ARE           *
* DISCLAIMED. IN NO EVENT SHALL SEGGER Microcontroller BE LIABLE FOR *
* ANY DIRECT, INDIRECT, INCIDENTAL, SPECIAL, EXEMPLARY, OR           *
* CONSEQUENTIAL DAMAGES (INCLUDING, BUT NOT LIMITED TO, PROCUREMENT  *
* OF SUBSTITUTE GOODS OR SERVICES; LOSS OF USE, DATA, OR PROFITS;    *
* OR BUSINESS INTERRUPTION) HOWEVER CAUSED AND ON ANY THEORY OF      *
* LIABILITY, WHETHER IN CONTRACT, STRICT LIABILITY, OR TORT          *
* (INCLUDING NEGLIGENCE OR OTHERWISE) ARISING IN ANY WAY OUT OF THE  *
* USE OF THIS SOFTWARE, EVEN IF ADVISED OF THE POSSIBILITY OF SUCH   *
* DAMAGE.                                                            *
*                                                                    *
**********************************************************************
*                                                                    *
*       SystemView version: 3.30                                    *
*                                                                    *
**********************************************************************
-------------------------- END-OF-HEADER -----------------------------

File    : SEGGER_SYSVIEW_Config_FreeRTOS.c
Purpose : Sample setup configuration of SystemView with FreeRTOS.
Revision: $Rev: 7745 $
*/
#include "FreeRTOS.h"
#include "SEGGER_SYSVIEW.h"
#include "cfg.h"
#include "app_sync.h"

extern const SEGGER_SYSVIEW_OS_API SYSVIEW_X_OS_TraceAPI;

/*********************************************************************
*
*       Defines, configurable
*
**********************************************************************
*/
// The application name to be displayed in SystemViewer
#define SYSVIEW_APP_NAME        "Varitest"

// The target device name
#define SYSVIEW_DEVICE_NAME     "STM32"

// Frequency of the timestamp. Must match SEGGER_SYSVIEW_GET_TIMESTAMP in SEGGER_SYSVIEW_Conf.h
#define SYSVIEW_TIMESTAMP_FREQ  (configCPU_CLOCK_HZ)

// System Frequency. SystemcoreClock is used in most CMSIS compatible projects.
#define SYSVIEW_CPU_FREQ        configCPU_CLOCK_HZ

// The lowest RAM address used for IDs (pointers)
#define SYSVIEW_RAM_BASE        (0x24000000)

/********************************************************************* 
*
*       _cbSendSystemDesc()
*
*  Function description
*    Sends SystemView description strings.
*/
static void _cbSendSystemDesc(void) {
  SEGGER_SYSVIEW_SendSysDesc("N=ATEsystem_Varitest,D=STM32H725,O=FreeRTOS");

  SEGGER_SYSVIEW_SendSysDesc("I#15=SysTick,I#53=UART PC,I#87=UART MEGA,I#27=DMA TC UART PC,I#72=DMA TC UART MEGA");
  //SEGGER_SYSVIEW_SendSysDesc("I#15=SysTick");

  SEGGER_SYSVIEW_NameResource((U32)&sem1_comm_pc, "sem1 comm pc");
  SEGGER_SYSVIEW_NameResource((U32)&sem2_comm_mega, "sem2 comm mega");
  SEGGER_SYSVIEW_NameResource((U32)&sem3_test, "sem3 test");
  SEGGER_SYSVIEW_NameResource((U32)&buff_mtx1, "mtx1");
}

/*********************************************************************
*
*       Global functions
*
**********************************************************************
*/
void SEGGER_SYSVIEW_Conf(void) {
  SEGGER_SYSVIEW_Init(SYSVIEW_TIMESTAMP_FREQ, SYSVIEW_CPU_FREQ, 
                      &SYSVIEW_X_OS_TraceAPI, _cbSendSystemDesc);
  SEGGER_SYSVIEW_SetRAMBase(SYSVIEW_RAM_BASE);
}

/*************************** End of file ****************************/
