ItsGoodButStill/IGBS-Rocket-v2/(commit log)

2022-02-13 PCB CAD - update
    [IGBS-Rocket-v2.sch]
2022-02-16 + schematics done
    [IGBS-Rocket-v2_rev1.sch]
2022-02-18 * schematics is validated and ready for layout
    [IGBS-Rocket-v2_rev1.sch]
2022-02-20 + PCB - BOM created * minor adjustments to PCB schematics
    [IGBS-Rocket-v2_rev1.brd, IGBS-Rocket-v2_rev1.sch, IGBS-Rocket-v2_rev1_BOM.xlsx]
2022-02-27 + PCB BOM
    [IGBS-Rocket-v2_rev1.brd, IGBS-Rocket-v2_rev1.sch, IGBS-Rocket-v2_rev1_BOM.xlsx]
2022-03-04 * PCB layout 30 % T strain-gauge modules to sch
    [IGBS-Rocket-v2_rev1.brd, IGBS-Rocket-v2_rev1.sch, IGBS-Rocket-v2_rev1_BOM.xlsx]
2022-03-06 + PCB schematic is DONE + BOM (Mouser) is DONE
    [IGBS-Rocket-v2_rev1.brd, IGBS-Rocket-v2_rev1.sch, IGBS-Rocket-v2_rev1_BOM.xlsx, mouser-template.xls]
2022-03-11 * PCB: 12V regulator added, P-FET HSS is now last missing part
    [IGBS-Rocket-v2_rev1.brd, IGBS-Rocket-v2_rev1.sch]
2022-03-13 + PCB schematics is DONE (added 12V BOOST + 3 servos)
    [IGBS-Rocket-v2_rev1.brd, IGBS-Rocket-v2_rev1.sch, IGBS-Rocket-v2_rev1_BOM.xlsx]
2022-03-23 + PCB layout done (DXF, STEP, BRD, PNG)
    [IGBS-Rocket-v2_rev1.brd, IGBS-Rocket-v2_rev1.sch, IGBS-Rocket-v2_rev1_BOM.xlsx, IGBS-Rocket-v2_rev1_bot.dxf, IGBS-Rocket-v2_rev1_top.dxf]
2022-03-23 * minor fixes
    [IGBS-Rocket-v2_rev1.brd, IGBS-Rocket-v2_rev1.sch]
2022-03-25 * PCB schematics upgrade (removed all modules) last thing GPS part needs to be done
    [IGBS-Rocket-v2_rev1.brd, IGBS-Rocket-v2_rev1.sch]
2022-03-26 + PCB layout DONE + PCB 3D model is ready
    [IGBS-Rocket-v2_rev1.brd, IGBS-Rocket-v2_rev1.sch, IGBS-Rocket-v2_rev1_bot.dxf, IGBS-Rocket-v2_rev1_top.dxf]
2022-03-26 * 3D model of hole minor fix
    [IGBS-Rocket-v2_rev1.brd, IGBS-Rocket-v2_rev1.sch]
2022-03-26 + PCB 3D IPT
2022-03-27 + PCB layout checking and cleaning up (silkscreen)
    [IGBS-Rocket-v2_rev1.brd, IGBS-Rocket-v2_rev1.sch]
2022-03-27 + PCB layout check done (routing follows)
    [IGBS-Rocket-v2_rev1.brd, IGBS-Rocket-v2_rev1.sch]
2022-04-01 * PCB routing 25 % done
    [IGBS-Rocket-v2_rev1.brd, IGBS-Rocket-v2_rev1.sch]
2022-04-03 + PCB routing signals 90 %
    [IGBS-Rocket-v2_rev1.brd, IGBS-Rocket-v2_rev1.sch]
2022-04-09 * PCB layout last 2 layers
    [IGBS-Rocket-v2_rev1.brd, IGBS-Rocket-v2_rev1.sch]
2022-04-10 * PCB layout fixes
    [IGBS-Rocket-v2_rev1.brd]
2022-04-18 + PCB layout is complete -> GERBERS are ready
    [IGBS-Rocket-v2_rev1.brd, IGBS-Rocket-v2_rev1.sch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]
